pav2000/ControlHeatPump2.0/Doc/OmronMX2.pdf

Пример настройки на компрессор с постоянными магнитами для Omron MX2

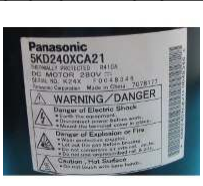
[picture p15: figure]
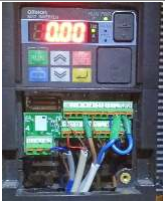
[picture p16: figure]

Необходимо переключится на PM мотор (b171=03) обнулить и сделать автонастройку
После выбора режима управления PM-двигателем (b171=03) и после выполнения инициализации (b180=01) большинство параметров группы «H», ориентированных на стандартный асинхронный двигатель, заменяется новыми параметрами. Эти новые параметры, используемые для регулировки характеристик двигателя,
Буква | Номер | Значение | Примечание
Н | 001 | 1
| 102 01
| 103 2.2
| 104 4
| 105 11
| 106 | 0.55 | Сопротивление одной обмотки
| 107 2.31
| 108 2.7
| 109 | 810 | надо подбирать влияет на потребление и шум
| 110 0.01
| 111 0.55
| 112 1.97
| 113 4.94
| 116 100
| 117 70
| 118 1
| 119 | 100 | надо подбирать наверное ?
| 121 0
| 122 50
| 123 0
| 131 10
| 132 10
| 133 30

| 134 100
c | 001 | 0 | Команда ход, настройка по умолчанию
c | 004 | 18 | Сброс ПЧ, настройка по умолчанию
c | 005 | 19 | (не настройка по умолчанию, надо менять) Подключение термореле к 5 входу (НЗ) цепляем на 5 и L
с | 026 | 05 | Сигнал ошибки от ПЧ (стандартная настройка) это выход ПЧ
b | 091 | 01 | Останов с выбегом
| 021 | 01 | Режим работы при перегрузке: включено во время разгона и вращения с постоянной скоростью
| 022 Задает уровень ограничения перегрузки в диапазоне от 20% | | до 200% от номинального тока ПЧ
| 023 | 1.0 | Задает время торможения при ограничении перегрузки обнаружении преобразователем перегрузки
| 171 | 03 | тип двигателя PM (постоянные магниты) Это первая настройка!!!
F | 002 | 20
| 003 20
A | 001 | 03 | Modbus источник управления
| 002 | 01 | Команда ход - Клеммы управления
| 003 120
| 004 120

Настройка плавного разгона-торможения
1. Определение максимальных частот.
Идем в даташит на компрессор и смотрим максимальные обороты. Дальше по формуле определяем максимальную частоту
Мах частота = (мах. обороты компрессора*число пар полюсов компрессора)/120
Для примера моего компрессора: максимальные обороты у меня 4800
Максимальная частота = 4800*4/120=160 гц - это тот максимум который можно подавать Важно понимать что существует определенная путаница в терминах в документации число пар полюсов и число полюсов. Обычно в независимости от того что написано имеется ввиду число пар полюсов.

### 2. Программирование верхних ограничений частот омрона

регистр A004 Максимальная частота (для моего компрессора я поставил 120, мне больше не надо, можно было поставить 160)
регистр A003 Основная частота должна быть меньше либо равна А004 (для себя установил 110). Это частота до которой с ростом частоты растет напряжение (дальше до максимальной частоты напряжение не растет).

### 3. Программирование времен разгона и торможения

регистр F002 Время разгона (у меня 30 сек)
регистр F003 Время торможения (у меня 30 сек)
В итоге получаем (при моих установках) при команде ход у установке целевой частоты 55 гц время разгона будет около 15 сек, т. е время разгона пропорционально изменению частоты.

При изменении частоты с 40 до 95 герц также будет разгон 15 секунд. Тоже с торможением.

Важные замечания:

### 1. Если разгон и торможение происходит плавно, то все ок и больше ничего не трогаем. При

рывках, вибрации, шуме (именно при разгоне), срабатывании защит, начинаем использовать встроенные средства омрона для борьбы ними (вырез частот, паузы при разгоне, настройка срабатывания защит, и т. д.). Можно сделать нелинейную характеристику разгона. Пока я не настроил нормально PM мотор у меня были проблемы на частоте 18-19 гц (резко росла нагрузка на этой частоте, может в компрессоре что открывалось).

### 2. Можно переключиться в режим торможение с выбегом, это значит просто снятие

напряжений с компрессора, он тормозится сам (т.е почти мгновенно, главное что бы удара не было в момент останова). У меня сейчас стоит останов с выбегом.

### 3. По настройке PM мотора омрон (большой документ, не выложить здесь)

скачиваем (https:/industrial.omron.us/en/media/MX2-V1_Inverter_Users_Manual_EN_201305_I585-E1-01_tcm849-112647.pd_f) и читаем раздел 6.8 -это наиболее полная инструкция по настройке и описанию параметров PM мотора Подчеркивание (1 шт из расширения файла) из ссылки убираем

### 4. Необходимо помнить что НК (страница конфигурация Тн - инвертор - доп. настройки) есть

также настройки максимальных и минимальных частот (это просто ограничения для изменения). Они должны соответствовать настройкам омрона.

Программирование входов/выходов

### 1. ВХОД5 Использование термозащиты компрессора (термореле), используется не стандартная

настройка С005=19 (термозащита), надо изменить регистр С005.

### 2. ВХОД1 Использование входа «Ход» используется настройка по умолчанию С001=00 3. ВХОД4 Использование сброса ПЧ — используется штатная настройка С004=18 4. ВЫХОД1 Сигнал ошибки используется штатная настройка С026=05

Начиная с прошивки 1.030 в НК есть возможность установить требуемые настройки ПЧ через НК (кнопка программирование в доп настройках инвертора). Но надо понимать, что это настройки для однофазного инвертора 2.2 кВт с указанным выше компрессором.

HITACHI | OMRON

## Элементы пульта оператора

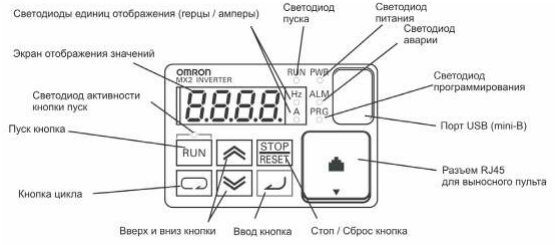
[picture p17: figure]

### - Светодиод пуска – загорается при подаче команды на запуск двигателя во

время начала вращения и отключается при остановке мотора.

### - Светодиод программирования – загорается при готовности к изменению

значений параметров и отключается в режиме контроля текущих параметров.

### - Светодиод активности кнопки пуск – загорается при активированной кнопке

и возможности с нее подать команду на запуск мотора.

### - Кнопка пуска Run – при нажатии производится запуск двигателя (сначала должен светиться светодиод над кнопкой). Направление вращения двигателя

можно задавать через функцию F004.

### - Кнопка Stop/Reset – при нажатии производится остановка двигателя (при этом используется значение времени замедления), а также, происходит сброс

возникающих ошибок.

### - Экран отображения значений – 4-х разрядный, 7-ми сегментный индикатор

для программирования и отображения параметров и текущих значений.

### - Светодиоды: Hz, A – загораются при отображении на экране частоты или

тока, соответственно.
- Светодиод Power – загорается при подаче питания на инвертор.
- Светодиод Alarm – загорается, когда инвертор в состоянии “Сбой”.
- Кнопка цикла – используется для входа в режим программирования, перемещения по группам параметров и функций.

### - Кнопки вверх и вниз – используются для перемещения вверх/вниз по списку внутри 1 группы параметров и функций отображаемых на индикаторе и для

изменения их значений.

### - Кнопка ввода – используется для входа в отображаемый параметр или функцию, для выхода из нее с сохранением установленного значения в

памяти EEPROM.

________________________________________________________________________ 10

## Испытание инвертора

### Процедура испытания требует минимум установочных параметров для запуска двигателя. Управление инвертором может осуществляться двумя

способами: посредством пульта оператора и через логические клеммы.

### Внимание! - Проверьте правильность подключения питающей сети и двигателя к

инвертору (см. схему).

### - Если для испытания используются логические клеммы, убедитесь, что

подключения клемм инвертора [P24], [1], [2], [H], [O] и [L] совпадают со схемой.
операций Шаги | Описание | Управление с пульта оператора | Управление через логические клеммы
1 | Установка источника задания частоты. * - заводская настройка | А001 = 02 (ввод значения выходной частоты в параметре F001) | А001 = 01*, (регулировка через аналоговые входы [H-O-L])
2 | Установка источника управляющих команд Пуск, в прямом направлении. * - заводская настройка | А002 = 02 (запуск мотора кнопкой RUN на пульте оператора) | А002 = 01*, (запуск мотора дискретным входом [1])
3 | Изменение направления вращения. | F004 = с 00* на 01 (запуск мотора кнопкой RUN на пульте оператора) | А002 = 01*, (запуск мотора дискретным входом [2])
4 | Установка номинальной частоты двигателя | А003 = 50*, (50 Гц)
5 | Установка числа полюсов двигателя (2 / 4 / 6 / 8) | Н004 = 4*, изменяйте только в том случае, если двигатель имеет другое число полюсов
6 | Вывод отображения текущей выходной частоты на индикаторе панели оператора | Выберите из группы параметров d параметр d001, нажмите кнопку Ввод., на индикаторе появится 0.0 – значение текущей частоты
7 | Установите среднее значение задания частоты | В параметре F001 установите 25Гц | Подайте около 5В на клеммы [О]-[L]
8 | Дайте команду Пуск мотора | Нажмите кнопку RUN. Мотор должен начать разгон. | Замкните клемму [Р24] и [1]. Мотор должен начать разгон.
9 | Изменение скорости мотора | В F001 измените значение частоты. Мотор изменит скорость. | Измените напряжение на [О]-[L]. Мотор изменит скорость.
10 | Контроль потребляемого тока | Отображение потребляемого мотором тока в d002. Потребляемый ток должен быть меньше или равен номинальному току преобразователя частоты.
11 | Остановка мотора | Нажмите кнопку STOP/RESET. Мотор должен начать остановку. | Разомкните клеммы [Р24] и [1]. Мотор должен начать остановку.

12

## Коды ошибок

Преобразователи частоты серии МХ2 имеют защиту от перегрузки по току,

### от повышенного/ пониженного напряжения и много других. При срабатывании защиты отключается выход инвертора и остановка двигателя происходит в режиме свободного выбега. Перезагрузка частотного преобразователя и сброс ошибки

производится нажатием кнопки STOP/RESET.
Код ошибки | Наименование | Возможные причины сбоя
E01 | Защита от перегрузки по току при постоянной скорости | - Замыкание на выходе инвертора - Блокировка вала двигателя - Слишком большая нагрузка - Неправильно совершено подключение мотора Замечание: для серии SJ200 защита от перегрузки по току будет срабатывать при перегрузке 200% от номинального тока
E02 | Защита от перегрузки по току при замедлении
E03 | Защита от перегрузки по току при разгоне
E04 | Защита от перегрузки по току при других условиях | - Установлен слишком большой тормозной момент (А054) - Влияние электромагнитных помех на трансформатор тока
E05 | Защита от перегрузки | Электронное тепловое реле определило перегрев мотора
E06 | Защита от перегрузки тормозного резистора | Превышается время или коэффициент использования регенеративного торможения, слишком большой ток торожения
E07 | Защита от повышенного напряжения | Энергия, отдаваемая двигателем при торможении, вызывает увеличение напряжения в контуре постоянного тока выше порогового значения
E08 | Ошибка EEPROM | Влияние электромагнитных помех или высокой температуры на встроенную память EEPROM
E09 | Защита от пониженного напряжения | Пониженное напряжение в контуре постоянного тока может вызвать неправильное функционирование инвертора
E10 | Ошибка измерения тока | Выход из строя цепей измерения потребляемого мотором тока
E11 | Ошибка CPU | Сбои в работе микропроцессорного модуля CPU
E12 | Сбой во внешней цепи | Подан сигнал на дискретный вход с функцией [EXT] (сбой в работе внешнего устройства)
E13 | USP – предотвращение перезапуска при восстановлении питания | Когда на инвертор подаётся питание при наличии команды Пуск мотора происходит сбой с блокировкой возможность запуска пока не сброшен сбой, если активна функция USP

13

Код ошибки | Наименование | Возможные причины сбоя
E14 | Защита от замыкания на землю | Замыкание на землю между выходом инвертора и корпусом мотора (заземлением) в момент теста питания (между подачей питания на ПЧ и пуском мотора). Данная функция обеспечивает защиту инвертора, но не людей.
E15 | Защита от повышенного напряжения на входе | Сетевое напряжение превышало допустимое значение в течение 100сек режима Стоп.
E21 | Тепловая защита | Внутренняя температура инвертора (силового модуля) превышает пороговое значение.
E22 | Ошибка связи с CPU | Ошибка связи между двумя процессорами
E25 | Авария основных цепей | Влияние помех или повреждение цепей основных элементов.
E30 | Ошибка драйвера | Внутренняя ошибка в цепях защиты между CPU и драйвером из-за влияния помех или повреждения.
E35 | Термисторная защита | Происходит если термистор, подключенный к клеммам 5 (с функцией ТНМ) и L слишком сильно нагрелся
E36 | Ошибка тормоза | Происходит если в b120 установлен 01 и не получен сигнал подтверждения от тормоза после истечения времени b124. Или когда выходной ток не достигает значения b126 в течение времени b121.
E37 | Безопасный стоп | Подан сигнал безопасного стопа
E38 | Защита от перегрузки на маленькой скорости | Перегрузка во время работы мотора на очень маленькой скорости
E40 | Ошибка пульта оператора | Проблема связи между инвертором и клавиатурой пульта оператора
E41 | Ошибка связи сети ModBus | Если С076=00 и произошла проблема связи в сети ModBus
E43 | Некорректная инструкция в программе EzSQ | Программа сохраненная в памяти инвертора уничтожена, или терминал PRG был включен без программы загруженной в инвертор.
E44 | Ошибка счета в программе EzSQ | Подпрограммы, if-условия, или for-циклы вложены в более чем в восемь уровней
E45 | Ошибка инструкции в программе EzSQ | Инвертор обнаруживал команду, которая не может быть выполнена (взаимопротиворечие).
E50 – E59 | Пользовательские ошибки (0 – 9) в программе EzSQ | Ошибка пользователя, заложенная в программе EzSQ
E60 – E69 | Ошибки в подключенных опциональных платах | Детальные пояснения каждой из ошибок в инструкции к опциональной плате

14

Код ошибки | Наименование | Возможные причины сбоя
E80 | Отключение энкодера | Если провода энкодера разъединены, обнаружена ошибка подключения, повреждение энкодера или выходной сигнал энкодера не поддерживается преобразователем
E81 | Превышение скорости | Скорость мотора выше значения А004хР026
E83 | Ошибка диапазона позиционирования | Если текущая позиция превышает диапазон позиционирования P072-P073
| Сброс. (вращение сегментов на дисплее) | На дискретный вход с функцией RS подается управляющее напряжение или нажата кнопка Stop/Reset
| Пониженное напряжение | Входное напряжение питания ниже порогового значения
| Ожидание перезапуска | Отображается после аварии перед рестартом
| Команда ограничения работы | Ограничение направления с командой RUN в параметре b035
| Сброс истории ошибок | Отображается во время сброса истории ошибок
| Нет данных, отсутствие ошибок в архиве | В архиве отсутствует авария / предупреждение
| Ошибка связи (мигает) | Проблема связи между инвертором и вспомогательным выносным пультом
| Автонастройка завершена успешно | Автонастройка завершена успешно
| Автонастройка не удалась | Автонастройка не удалась

15

## Ошибки программирования

### Преобразователи частоты имеют специальные коды - коды ошибок программирования (они начинаются символом ).Коды ошибок программирования означают, что при программировании была допущена ошибка и установленные

значения параметров противоречат одно другому. После обнаружения конфликта,

### на экране высвечивается определенный код, также происходит мигание светодиода PRG до тех пор, пока в соответствующем параметре не будет установлено значение из требуемого диапазона. Последний из кодов ошибок программирования

фиксируется в параметре D090.

Код предупреждения | Условия
001 | А061 | > | А004
002 | А062 | > | А004
005 | F001 или A020 | > | A004
015 | F001 или A020 | > | A061
025 | A062 | > | F001 или A020
031 | A082 | > | A061
032 | A082 | > | A062
035 | A082 | > | F001 или A020
036 | A082 | > | A021 – A035
037 | A082 | > | A038
085 | F001 или A020 | = | A063/A063/A063 ± A064/A066/A068
086 | A021 – A035 | = | A063/A063/A063 ± A064/A066/A068
091 | B112 | > | A061
092 | B112 | > | A062
095 | B112 | > | F001 или A020
201 | А261 | > | А204
202 | А262 | > | А204
205 | F001 или A220 | > | A204
215 | F001 или A220 | > | A261
225 | A262 | > | F001 или A220
231 | A082 | > | A261
232 | A082 | > | A262
235 | A082 | > | F001 или A220
285 | F001 или A220 | = | A063/A063/A063 ± A064/A066/A068
291 | B112 | > | A261
292 | B112 | > | A262
295 | B112 | > | F001 или A220

17

## Восстановление заводских стандартных настроек

Функцио-нальный код | Наименование/Описание
b084 | Режим инициализации (параметров или истории ошибок): • 00: инициализация не происходит, • 01: очистка истории сбоев, • 02: установка заводских параметров, • 03: очистка истории сбоев и установка заводских параметров, • 04: очистка истории сбоев и установка заводских параметров и сброс программы
b094 | Инициализация параметров: • 00: все параметры, • 01: все параметры, кроме функций входов, выходов и коммуникационных, • 02: только параметры из Uxxx, • 03: все параметры, кроме Uxxx и b037
b085 | Код страны для инициализации: • 00: Япония / США, • 01: Европа
b180 | Триггер, выпоняющий инициализацию с учетом b084, b085, b094: • 00: инициализация невозможна, • 01: инициализация выполниется

18

## Внимание, это важно!!!

## Подробное описание всех указанных, а также специальных параметров и функций представлено в полной версии инструкции по

эксплуатации данного оборудования.

## (смотрите на CD в комплекте поставки или спрашивайте у поставщика)

## Таблицы параметров

## Группа параметров «D»: функции отображения информации

Функцио-нальный код | Наименование/Описание | Единицы измерения
d001 | Отображение текущей выходной частоты 0.00 – 400.0Гц Если в b163 установлено 01, то задание частоты возможно в параметре d001 кнопками вверх/вниз (как в F001) | Гц
d002 | Отображение выходного тока, потребляемого мотором | А
d003 | Отображение режимов вращения вала двигателя Прямое Стоп | | | -
d004 | Действительное значение сигнала обратной связи при ПИД-регулировании (PV). Его масштабирование/ привязка к физической величине производится в А075 | | | %
d005 | Состояние программируемых входных логических клемм | | 67 | | 12345 | -
d006 | Состояние программируемых выходных логических клемм | -
d007 | Отображение преобразованного значения выходной частоты (произведение выходной частоты на поправочный коэффициент, устанавливаемый в b086). | Определяется пользователем
d008 | Отображение текущей частоты, от -400 до 400 | Гц
d009 | Отображение задания крутящего момента, от -200 до +200 | %
d010 | Отображение ограничения крутящего момента, от -200 до +200 | %
d012 | Отображение текущего крутящего момента, от -200 до +200 | %
d013 | Отображение выходного напряжения, от 0.0 до 600.0 | В
d014 | Отображение потребляемой мотором мощности, от 0.0 до 999.9 | кВт
d015 | Счетчик потребленной электроэнергии из сети, от 0 до 9999000 | кВт/ч
d016 | Общее время работы преобразователя частоты с двигателем. Диапазон: 0…9999 / 1000…9999 / Г100…Г999 (10000…99900) | час
d017 | Общее время подключения преобразователя частоты к сети. Диапазон: 0…9999 / 1000…9999 / Г100…Г999 (10000…99900) | час
d018 | Отображение температуры радиатора, от -020. до 150.0 | °С

19

Вкл
Выкл

Номера входов

Вкл
Выкл

1112
Номера выходов

AL

Обратное
вращение

вращение

## Группа параметров «F»

Функциональный код | Наименование/ Описание | Значение по умолчанию | Установленное значение
F001 | Установка выходной частоты | 0.0Гц
F002 | Установка времени разгона (1-я ступень) | 10.0с
F202 | Установка времени разгона для 2-го двигателя (1-я ступень) | 10.0с
F003 | Установка времени торможения (1я ступень) | 10.0с
F203 | Установка времени торможения для 2-го двигателя (1-я ступень) | 10.0с
F004 | Установка направления вращения двигателя при его запуске кнопкой RUN с пульта оператора: - 00: прямое вращение - 01: обратное вращение | 00

20

Функцио-нальный код | Наименование/Описание | Единицы измерения
d022 | Контроль работоспособности
d023 | Отображение счетчика программы, 0 до 1024, функция контроллера
d024 | Отображение номера программы, функция контроллера
d025 | Монитор 0 пользователя, функция контроллера, -2147483647 до 2147483647
d026 | Монитор 1 пользователя, -2147483647 до 2147483647
d027 | Монитор 2 пользователя, -2147483647 до 2147483647
d028 | Счетчик импульсов, 0 до 2147483647 | | имп
d029 | Отображение задания позиционирования, -268435455 до 268435455 | | имп
d030 | Отображение текущей позиции, -268435455 до 268435455 | | имп.
d050 | Отображение 2 различных параметров выбранных в b160и b161
d060 | Текущее состояние инвертера: I-C: , I-v: , P:
d080 | Счетчик сбоев преобразователя, от 0 до 65530 | | шт.
d081 | Отображение сбоя 1, причина, частота, ток, напряжение, время работы, время включения
d082 | Отображение сбоя 2, причина, частота, ток, напряжение, время работы, время включения
d083 | Отображение сбоя 3, причина, частота, ток, напряжение, время работы, время включения
d084 | Отображение сбоя 4, причина, частота, ток, напряжение, время работы, время включения
d085 | Отображение сбоя 5, причина, частота, ток, напряжение, время работы, время включения
d086 | Отображение сбоя 6, причина, частота, ток, напряжение, время работы, время включения
d090 | Отображение ошибки программирования (код предупреджения)
d102 | Напряжение в цепи постоянного тока, от 0.0 до 999.9 | | В
d103 | Степень нагрузки на встроенное тормозное устройство, 0.0 до 100.0 | | %
d104 | Отображение расчетной тепловой нагрузки мотора, электронное тепловое реле, 0.0 до 100.0 | | %

Проблема
Нормально

12
1 - конденсаторы на основной плате, 2 - охлаждающие вентиляторы

## Группа параметров «А»

Функциональный код | Наименование / Описание | Значение по умолчанию | Установленное значение
А001 / А201 | Установка источника задания частоты: - 00: потенциометром на пульте оператора, - 01: внешними аналоговыми сигналами через клеммы, - 02: с помощью функции F001, - 03: через сеть ModBus, - 04: опция, - 06: последовательностью импульсов, - 07: программой контроллера, - 10: через функцию вычисления, | 01
А002 / А202 | Установка источника команды на запуск двигателя: - 01: с помощью дискретных входов, - 02: кнопкой RUN на пульте оператора или цифровым оператором, - 03: через сеть ModBus, - 04: опция, | 01
А003 / А203 | Установка номинальной частоты мотора | 60.0Гц
А004 / А204 | Установка максимальной частоты, от номинальной до 400 | 60.0Гц
А005 | [АТ]: выбор входа задания частоты - 00: производится выбор между входами [O] и [OI] ([АТ]: ВКЛ= OI, ВЫКЛ=О), - 02: выбор между входом [O] и потенциометром на пульте оператора ([АТ]: ВКЛ= пот., ВЫКЛ=О), - 03: выбор между входом [OI] и потенциометром на пульте оператора ([АТ]: ВКЛ= пот., ВЫКЛ= OI), | 00
А011 | Частота соответствующая начальной точке аналогового входа [O]. | 0.0Гц
А012 | Частота соответствующая конечной точке аналогового входа [O]. | 0.0Гц
А013 | Напряжение, соответствующее рабочего диапазона аналогового входа [O] относительно 10В | 0%
А014 | Напряжение, соответствующее концу рабочего диапазона аналогового входа [O] относительно 10В | 100%
А015 | Стартовая частота при задании со входа [O] - 00: значение в А011 - 01: 0Гц | 01
А016 | Постоянная времени фильтра аналогового входа, от 1 до 30 х2мс, 31=500мс | 8.
А017 | Выбор функционирования встроенного программируемого контроллера: - 00: не работает, - 01: работает, | 00
А019 | Выбор функционирования многоскоростного режима: - 00: двоичным кодом 16 скоростей используя 4 дискретных входа, - 01: битовым выбором 8 скоростей используя 7 дискретных входов, | 00

21

Функциональный код | Наименование / Описание | Значение по умолчанию | Установленное значение
А020 / А220 | Нулевая скорость первого /второго мотора при многоскоростном режиме | 0.00Гц
А021 А022 А023 | А035 | Установка частоты для каждой отдельной ступени скорости (от 1 до 15) при режиме ступенчатого задания скорости | 0.00Гц
А038 | Установка частоты для режима «Jog» | 6.00Гц
А039 | Установка метода остановки мотора после режима «Jog»: - 00: свободный выбег, режим «Jog» невозможен во время вращения двигателя, - 01: торможение по заданному времени замедления, режим «Jog» невозможен во время вращения двигателя, - 02: торможение постоянным током, режим «Jog» невозможен во время вращения двигателя, - 03: свободный выбег, режим «Jog» возможен во время вращения двигателя, - 04: замедление и стоп, режим «Jog» возможен во время вращения двигателя, - 05: торможение постоянным током, режим «Jog» возможен во время вращения двигателя, | 04
А041 / А241 | Установка способа повышения крутящего момента - 00: вручную - 01: автоматически | 00
А042 / А242 | Установка значения повышения момента для ручного режима, от 0 до 20% относительно линейной V/f-хар. | 1.0%
А043 / А243 | Частота, соответствующая точке повышения момента на V/f-хар. для ручного режима, от 0 до 50% (100%=А004) | 5.0%
А044 / А244 | Выбор вида кривой V/f – характеристики - 00: V/f – линейная (постоянный момент), - 01: V/f – квадратичная (пониженный момент 1.7), - 02: создаваемая V/f, - 03: безсенсорный векторный режим, | 00
А045 / А245 | Величина выходного напряжения | 100%
А046 / А246 | Значение компенсации напряжения при автоматическом повышении момента | 100.
А047 / А247 | Значение компенсации скольжения при автоматическом повышении момента | 100.
А051 | Активация торможения постоянным током: - 00: не действует, - 01: действует в режиме стоп, - 02: действует со значения частоты, | 00
А052 | Установка частоты активации торможения постоянным током, от b082 до 60Гц | 0.5Гц
А053 | Установка времени ожидания перед активацией торможения постоянным током, от 0 до 5с | 0.0с

22

23

Функциональный код | Наименование / Описание | Значение по умолчанию | Установленное значение
А054 | Установка момента торможения постоянным током при замедлении, от 0 до 100% | 50%
А055 | Установка времени торможения постоянным током при замедлении, от 0 до 60с | 0.5с
А056 | Торможения постоянным током: - 00: включается появлением [DB] и действует время А055, - 01: включается и действует в течении наличия сигнала [DB], | 01
А057 | Установка момента торможения постоянным током при разгоне, от 0 до 100% | 0%
А058 | Установка времени торможения постоянным током при разгоне, от 0 до 60с | 0.0с
А059 | Установка несущей частоты при торможении постоянным током, от 2 до 15кГц | 5.0кГц
А061/А261 | Установка верхней границы частоты, от А062 до А004, значение 0 отключает ограничение. | 0.0Гц
А062/А262 | Установка нижней границы частоты, b082 до А061, значение 0 отключает ограничение. | 0.0Гц
А063 А065 А067 | Установка резонансной частоты | 0.0Гц
А064 А066 А068 | Установка ширины скачка (гистерезиса) | 0.5Гц
А069 | Частота начала задержки разгона | 0.00Гц
А070 | Время задержки разгона | 0.0с
А071 | Активация ПИД-регулятора - 00: не действует, - 01: действует, - 02: действует с инвертированием, | 00
А072 | Пропорциональная составляющая | 1.0
А073 | Интегральная составляющая | 1.0с
А074 | Дифференциальная составляющая | 0.0с
А075 | Коэффициент масштабирования сигнала обратной связи для ПИД-регулятора (PV) | 1.00
А076 | Установка входа для сигнала обратной связи (PV): - 00: аналоговый вход [OI], - 01: аналоговый вход [O], - 02: сеть ModBus, - 03: импульсный вход, - 10: через функцию вычисления, | 00
А077 | Реверсирование ПИД-регулятора: - 00: выключено, - 01: включено, | 00
А078 | Ограничение выхода ПИД-регулятора | 0.0%
А079 | Выбор прямого значения ПИД-регулятора: - 00: не активен, - 01: аналоговый вход [O], - 02: аналоговый вход [OI], | 00

24

код | | умолчанию | значение
А081 / A281 | Режимы работы функции АРН (автоматическое регулирование напряжения): - 00: действует всегда, - 01: не действует, - 02: не действует при торможении | 00
А082 / A282 | Установка напряжения для режима АРН | 400
А083 | Постоянная времени фильтра АРН | 0.3с
А084 | Коэффициент замедления для АРН | 100%
А085 | Режим функционирования: - 00: нормальное функционирование, - 01: энергосберегающий режим, | 00
А086 | Настройка энергосберегающего режима | 50.0%
А092 / А292 | Время разгона по второй ступени | 10.0с
А093 / А293 | Время торможения по второй ступени | 10.0с
А094/А294 | Выбор способа перехода на Ускорение2 / Торможение2: - 00: подачей сигнала на вход 2СН, - 01: достижением частот А095 и А096, - 02: сменой направления вращения, | 00
А095/А295 | Установка частоты перехода с первой ступени ускорения на вторую | 0.0Гц
А096/А296 | Установка частоты перехода с первой ступени торможения на вторую | 0.0Гц
А097 | Выбор кривой разгона: - 00: линейная, - 01: S-образная, - 02: U-образная, - 03: ∩-образная, - 04: EL-S-образная, | 00
А098 | Выбор кривой торможения: - 00: линейная, - 01: S-образная, - 02: U-образная, - 03: ∩-образная, - 04: EL-S-образная, | 00
А101 | Частота соответствующая начальной точке аналогового входа [OI]. | 0.0Гц
А102 | Частота соответствующая конечной точке аналогового входа [OI]. | 0.0Гц
А103 | Ток, соответствующий началу рабочего диапазона аналогового входа [OI] относительно 20мА | 20.0%
А104 | Ток, соответствующий концу рабочего диапазона аналогового входа [OI] относительно 20мА | 100%
А105 | Стартовая частота при задании со входа [OI] - 00: значение в А101 - 01: 0Гц | 00
А131 | Постоянная кривой разгона: - 00: наименьшая выпуклость, … - 10: наибольшая выпуклость | 02
А132 | Постоянная кривой замедления: - 00: наименьшая выпуклость, … - 10: наибольшая выпуклость | 02

код | | умолчанию | значение
А141 | Выбор ввода 1 для функции вычисления - 00: пульт оператора -F001, - 01: пульт оператора -потенциометр, - 02: вход [О], - 03: вход [OI], - 04: сетевой порт, - 05: опция, - 07: импульсный вход, | 02
А142 | Выбор ввода 2 для функции вычисления - 00: пульт оператора -F001, - 01: пульт оператора -потенциометр, - 02: вход [О], - 03: вход [OI], - 04: сетевой порт, - 05: опция, - 07: импульсный вход, | 03
А143 | Вычислительные действия: - 00: сумма А141+А142, - 01: вычитание А141-А142, - 02: умножение А141*А142, | 00
А145 | Прибавляемое значение частоты, ADD | 0.00Гц
А146 | Выбор действия для добавления частоты: - 00: выходная частота + А145, - 01: выходная частота - А145, | 00
А150 | EL-S-образная кривая разгона участка 1 | 10%
А151 | EL-S-образная кривая разгона участка 2 | 10%
А152 | EL-S-образная кривая остановки участка 1: от 0 до 50 | 10%
А153 | EL-S-образная кривая остановки участка 1: от 0 до 50 | 10%
А154 | Частота задержки замедления | 0Гц
А155 | Время задержки замедления | 0с
А156 | Нижний порог функционирования ПИД, ниже этого значения ПИД отключается | 0Гц
А157 | Время ожидания перед отключением/ включением ПИД при пересечении А156 | 0с
А161 | Частота соответствующая начальной точке встроенного потенциометра. | 0Гц
А162 | Частота соответствующая конечной точке встроенного потенциометра | 0Гц
А163 | Положение (уровень) начала встроенного потенциометра | 0%
А164 | Положение (уровень) конца встроенного потенциометра | 100%
А165 | Стартовая частота при задании встроенного потенциометра - 00: значение в А161 - 01: 0Гц | 01

25

## Группа параметров «В»:

Функциональный код | Наименование / Описание | Значение по умолчанию | Установленное значение
b001 | Выбор режима перезапуска после провала напряжения питания: - 00: выдача сообщения об ошибке, - 01: старт с частоты 0Гц, - 02: старт с подхватом текущей частоты, - 03: старт с подхватом текущей частоты и остановка с выдачей сообщения об ошибке, - 04: ?, | 00
b002 | Допустимое время провала напряжения питания от 0.3 до 25.0 с | 1.0с
b003 | Время ожидания перед перезапуском мотора от 0.3 до 100 с | 1.0с
b004 | Выдача сообщения о провале питания или о пониженном напряжении: - 00: не активирована, - 01: активирована, - 02: не активна при замедлении и стопе, | 00
b005 | Количество перезапусков при провале напряжения питания до появления сбоя: - 00: перезапуск производится 16 раз, - 01: перезапуск производится всегда, | 00
b007 | Порог частоты подхвата. Перезапуск произведется с 0Гц если скорость мотора соответствует частоте ниже этой | 0.00Гц
b008 | Выбор повторной попытки после сбоя по перенапряжению или перегрузки по току: - 00: сообщение об ошибке без перезапуска, - 01: старт с частоты 0Гц, - 02: старт с подхватом текущей частоты, - 03: старт с подхватом текущей частоты и остановка с выдачей сообщения об ошибке, 04: ?, | 00
b010 | Выбор повторной попытки после сбоя по перенапряжению или перегрузки по току:: от 1 до 3 раз | 3
b011 | Время ожидания после сбоя по перенапряжению или перегрузки по току: от 0.3 до 100 с | 1.0с
b012 / b212 | Уровень установки электронного теплового реле | Ном. ток инвертора
b013 / b213 | Характеристика электронного теплового реле: - 00: пониженный момент, - 01: постоянный момент - 02: настраиваемая характеристика, | 01
b015 | Настраиваемая тепловая характеристика, частота 1 | 0Гц
b016 | Настраиваемая тепловая характеристика, ток 1 | 0.0А
b017 | Настраиваемая тепловая характеристика, частота 2 | 0Гц
b018 | Настраиваемая тепловая характеристика, ток 2 | 0.0А

26

код | | умолчанию | значение
b019 | Настраиваемая тепловая характеристика, частота 3 | 0Гц
b020 | Настраиваемая тепловая характеристика, ток 3 | 0.0А
b021 / b221 | Режим ограничения тока: - 00: не действует, - 01: действует при разгоне и постоянной скорости, - 02: действует при постоянной скорости, - 03: действует при разгоне и постоянной скорости, включая скорости с генераторным режимом, | 01
b022 / b222 | Установка уровня ограничения тока, А | Ном. ток × 1.5А
b023 / b223 | Время замедления для режима ограничения тока | 1.0с
b024 | Режим 2 ограничения тока: - 00: не действует, - 01: действует при разгоне и постоянной скорости, - 02: действует при постоянной скорости, - 03: действует при разгоне и постоянной скорости, включая скорости с генераторным режимом, | 01
b025 | Установка 2 уровня ограничения тока, А | Ном. ток × 1.5А
b026 | Время 2 замедления для режима ограничения тока | 1.0с
b027 | Сдерживание перегрузки по току: - 00: не возможно, - 01: возможно, | 01
b028 | Значение тока для функции активного подхвата частоты, А | Ном. ток инвертора
b029 | Диапазон замедления для функции активного подхвата частоты | 0.5с
b030 | Стартовая частота для функции активного подхвата частоты: - 00: частота предыдущего отключения, - 01: максимальная частота, - 02: установленная частота, | 00
b031 | Выбор способа блокировки параметров - 00: редактирование параметров кроме В031 блокируется подачей сигнала [SFT], - 01: редактирование параметров кроме В031 и F001 блокируется подачей сигнала [SFТ], - 02: все кроме В031 блокируется, - 03: все кроме В031 и F001 блокируется, - 10: не блокируется изменение данных, | 01
b033 | Длинна кабеля к мотору | 10м
b034 | Установка счетчика времени работы/включения для выходного сигнала | 0час
b035 | Ограничение направления вращения: - 00: возможно вперед и назад, - 01: возможно только вперед, - 02: возможно только назад, | 00

27

код | | умолчанию | значение
b036 | Выбор возможности запуска при пониженном напряжении питания: - 0: отключено, -1: примерно 6мс, … - 255: примерно 1.5с, | 2
b037 | Ограничения отображаемых данных на дисплее: - 00: все данные отображаются, - 01: отображаются специальные функции, - 02: отображаются параметры пользователя (U), - 03: отображаются данные сравнения, - 04: основной дисплей, - 05: только функции группы d | 04
b038 | Выбор параметра для начального экрана: 001… 030 = d001 … d030, 201 = F001, 202 = ? | 001
b039 | Автоматическая регистрации параметров пользователя: - 00: не активна, - 01: активна, | 00
b040 | Выбор ограничения момента: - 00: поквадрантное ограничение, - 01: переключение с клемм управления, - 02: аналоговым входом О, | 00
b041 | Ограничение 1, движение вперед в 4 квадрантном режиме, от 0 до 200 % | 200%
b042 | Ограничение 2, движение назад с регенерацией в 4 квадрантном режиме, от 0 до 200 % | 200%
b043 | Ограничение 3, движение назад в 4 квадрантном режиме, от 0 до 200 % | 200%
b044 | Ограничение4, движение вперед с регенерацией в 4 квадрантном режиме, от 0 до 200 % | 200%
b045 | Ограничение момента, режим LADSTOP: - 00: не активна, - 01: активна, | 00
b046 | Защита от вращения назад: - 00: не активна, - 01: активна, | 01
b049 | Установка двойного значения: - 00: СТ-режим, - 01: VT-режим | 00
b050 | Управляемая остановка и стоп при пропадании напряжения питания (режим беспрерывной работы): - 00: авария, - 01: беспрерывное замедление и стоп, - 02: замедление с контролем DC напряжения, - 03: замедление с контролем DC напряжения, затем перезапуск | 00
b051 | Уровень переключения DC напряжения при пропадании питания: от 0 до 1000 В | 440В
b052 | Порог перенапряжения при пропадании питания: от 0 до 1000 В | 720В

28

код | | умолчанию | значение
b053 | Время замедления при пропадании питания: от 0.01 до 3600 с | 1с
b054 | Начальное понижение выходной частоты при пропадании питания: от 0.00 до 10.00 Гц | 0.00Гц
b060 | Максимальное значение окна компаратора О, от (b061 + гистерезис b062х2) до 100% | 100%
b061 | Минимальное значение окна компаратора О, от 0 до (b060 - гистерезис b062х2) | 0%
b062 | Ширина гистерезиса окна компаратора О, от 0 до (b060 - b061)/2 | 0%
b063 | Максимальное значение окна компаратора ОI, от (b064 + гистерезис b065х2) до 100% | 100%
b064 | Минимальное значение окна компаратора ОI, от 0 до (b063 - гистерезис b065х2) | 0%
b065 | Ширина гистерезиса окна компаратора ОI, от 0 до (b063 - b064)/2 | 0%
b070 | Рабочий уровень отключения О, от 0 до 100% или “no”-игнорирование | no
b071 | Рабочий уровень отключения ОI, от 0 до 100% или “no”-игнорирование | no
b075 | Температура окружающего воздуха: -10…+50 | 40°С
b078 | Сброс счетчика электроэнергии: - 00: нет сброса, - 01: сброс нажатием кнопки STR. | 00
b079 | Коэффициент отображения счетчика электроэнергии от 1 до 1000 | 1
b082 | Установка стартовой частоты, от 0.10 до 9.99Гц | 0.5Гц
b083 | Установка несущей частоты, от 0.5 до 15кГц | 2.0кГц
b084 | Режим инициализации (параметры или история сбоев): - 00: не происходит - 01: очистка истории сбоев, - 02: установка заводских параметров, - 03: очистка истории сбоев и установка заводских параметров, - 04: очистка истории сбоев и установка заводских параметров и сброс программы | 00
b085 | Код страны для инициализации: - 00: Япония / США, - 01: Европа | 00
b086 | Коэффициент масштабирования для отображаемой в d007 частоты, от 0.1 до 99.99 | 1.0
b087 | Действие кнопки STOP: - 00: действует, - 01: не действует, - 02: не действует только функция стоп, | 00
b088 | Режим перезапуска после FRS - 00: перезапуск с 0Гц, - 01: перезапуск с частоты определенной по реальной скорости мотора (подхват частоты), - 02: перезапуск с частоты определенной по реальной скорости мотора (активный подхват частоты), | 00
b089 | Автоматическое понижение несущей частоты: - 00: не действует, - 01: действует, зависит от выходного тока, - 02: действует, зависит от температуры, | 01
b090 | Значение использования тормозного устройства | 0%

29

код | | умолчанию | значение
b091 | Выбор способа остановки мотора: - 00: замедление по характеристике, - 01: FRS, свободный выбег, | 00
b092 | Работа вентиляторов охлаждения: - 00: работают всегда, - 01: работают при работе мотора, отключаются после 5 минут простоя мотора, - 02: работают по температуре, | 01
b093 | Сброс времени работы вентиляторов охлаждения: - 00: сброса нет, - 01: сброс, | 00
b094 | Инициализация параметров: - 00: все параметры, - 01: все параметры, кроме функций входов, выходов и коммуникационных, - 02: только параметры из Uxxx, - 03: все параметры, кроме Uxxx и b037 | 00
b095 | Работа тормозного устройства: - 00: не действует, - 01: действует только в режиме RUN, - 02: действует всегда, | 01
b096 | Уровень напряжения для активации тормозного устройства от 660 до 760 В, | 720В
b097 | Сопротивление тормозного резистора, подключенного к тормозному устройству | min Ом
b100 | Частота 1 для создаваемой V/f, от 0Гц до b102 | 0.
b101 | Напряжение 1 для создаваемой V/f, от 0 до 800В | 0.0
b102 | Частота 2 для создаваемой V/f, от 0Гц до b104 | 0.
b103 | Напряжение 2 для создаваемой V/f, от 0 до 800В | 0.0
b104 | Частота 3 для создаваемой V/f, от 0Гц до b106 | 0.
b105 | Напряжение 3 для создаваемой V/f, от 0 до 800В | 0.0
b106 | Частота 4 для создаваемой V/f, от 0Гц до b108 | 0.
b107 | Напряжение 4 для создаваемой V/f, от 0 до 800В | 0.0
b108 | Частота 5 для создаваемой V/f, от 0Гц до b110 | 0.
b109 | Напряжение 5 для создаваемой V/f, от 0 до 800В | 0.0
b110 | Частота 6 для создаваемой V/f, от 0Гц до b112 | 0.
b111 | Напряжение 6 для создаваемой V/f, от 0 до 800В | 0.0
b112 | Частота 7 для создаваемой V/f, от 0Гц до 400Гц | 0.
b113 | Напряжение 7 для создаваемой V/f, от 0 до 800В | 0.0
b120 | Режим управления тормозом: - 00: не действует, - 01: действует, | 00
b121 | Задержка наложения тормоза от 0.00 до 5.00 с | 0.00с
b122 | Задержка управления тормозом при разгоне от 0.00 до 5.00 с | 0.00с
b123 | Задержка управления тормозом при остановке от 0.00 до 5.00 с | 0.00с
b124 | Задержка управления тормозом при подтверждении от 0.00 до 5.00 с | 0.00с
b125 | Частота наложения тормоза, от 0.00 до 400Гц | 0.00
b126 | Ток наложения тормоза, от 0.0 до 2× ном. ток | Ном.ток
b127 | Частота торможения, от 0.00 до 400Гц | 0.00
b130 | Действие режима ограничения перегрузки по напряжению: - 00: не действует, - 01: действует, - 02: действует при разгоне, | 00
b131 | Напряжение ограничения перегрузки по напряжению, от 660 до 780В | 760В

30

код | | умолчанию | значение
b132 | Значение разгона и остановки для функции ограничения перегрузки по напряжению, от 0.1 до 30 с | 1.0с
b133 | Пропорциональная составляющая для функции ограничения перегрузки по напряжению, от 0.00 до 5 | 0.20
b134 | Интегральная составляющая для функции ограничения перегрузки по напряжению, от 0.000 до 150с | 1с
b145 | Режим входа GS: - 00: нет аварии, - 01: авария, | 00
b150 | Параметр, отображающийся на заблокированном встроенном дисплее, при подключении внешнего дисплея по RS422: 001=d001 … 030=d030 | 001
b160 | Первый параметр двойного монитора: 001=d001 … 030=d030 | 001
b161 | Второй параметр двойного монитора: 001=d001 … 030=d030 | 002
b163 | Задание частоты при отображении: - 00: не возможно, - 01: возможно, | 00
b164 | Автоматический возврат через 10мин к начальному дисплею, выбранному в b038: - 00: не возможен, - 01: возможен, | 00
b165 | Действие при потере связи/ сети: - 00: авария, - 01: авария после замедления и стопа, - 02: игнорирование, - 03: остановка на выбеге, FRS, - 04: замедление и стоп, | 02
b166 | Выбор записи/чтения данных: - 00: запись/чтение доступные, - 01: запись/чтение заблокированы | 00
b171 | Выбор режима инвертера: - 00: нет функции, - 01: стандартный индукционный мотор, - 02: мотор с постоянными магнитами | 00
b180 | Триггер, выпоняющий инициализацию с учетом b084, b085, b094: - 00: инициализация невозможна, - 01: инициализация выполниется,
b190 | Ввод пароля А от 0001 до FFFF, 0000-нет пароля | 0000
b191 | Подтверждение пароля А от 0000 до FFFF, | 0000
b192 | Ввод пароля В от 0001 до FFFF, 0000-нет пароля | 0000
b193 | Подтверждение пароля В от 0000 до FFFF, | 0000

31

## Группа параметров «С»:

Функциональный код | Наименование / Описание | Значение по умолчанию | Установленное значение
С001 | Функция входа [1] | Есть возможность присвоить данным входам по одной из 68 функций (см. стр. 40) | 00
С002 | Функция входа [2] | | 01
С003 | Функция входа [3], GS1-совместимый | | 02
С004 | Функция входа [4] ], GS2-совместимый | | 03
С005 | Функция входа [5] ], PTC-совместимый | | 09
С006 | Функция входа [6] | | 18
С007 | Функция входа [7] | | 13
С011 | Активное состояние входа [1] | - 00: нормально открытый [NO] - 01: нормально закрытый [NC] | 00
С012 | Активное состояние входа [2] | | 00
С013 | Активное состояние входа [3] | | 00
С014 | Активное состояние входа [4] | | 00
С015 | Активное состояние входа [5] | | 00
С016 | Активное состояние входа [6] | | 00
С017 | Активное состояние входа [7] | | 00
С021 | Функция выхода [11] ], EDM-совместимый | Есть возможность присвоить данным выходам по 1 из 48 функций, (см. стр. 41) | 01
С022 | Функция выхода [12] | | 00
С026 | Функция выхода реле аварийной сигнализации | | 05
С027 | Выбор сигнала для выхода [EO] | Есть возможность присвоить данному выходу 1 из 13 функции (см. стр. 42) | 07
С028 | Выбор сигнала для аналогового выхода [АМ] | Есть возможность присвоить данному выходу 1 из 11 функции (см. стр. 42) | 07

32

код | | умолчанию | значение
С030 | Ссылка на величину отображения тока, От 0.2×ном. ток до 2×ном. ток | Ном. ток
С031 | Активное состояние выхода [11] | - 00: нормально открытый [NO] - 01: нормально закрытый [NC] | 00
С032 | Активное состояние выхода [12] | | 00
С036 | Активное состояние выхода реле аварийной сигнализации | | 01
С038 | Выбор режима индикации о пониженном потребляемом токе: - 00: при разгоне, остановке и постоянной скорости, - 01: только при постоянной скорости, | | 01
С039 | Значение для режима индикации о пониженном потребляемом токе, от 0 до 2×ном.ток | | Ном. ток инвертора
С040 | Выбор режима индикации о повышенном потребляемом токе: - 00: при разгоне, остановке и постоянной скорости, - 01: только при постоянной скорости, | | 01
С041 / С241 | Значение для режима индикации о повышенном потребляемом токе, от 0 до 2×ном.ток | | Ном. ток инвертора
С042 | Установка значения достигнутой частоты при разгоне, от 0 до 400Гц | | 0.00Гц
С043 | Установка значения достигнутой частоты при замедлении, от 0 до 400Гц | | 0.00Гц
С044 | Установка превышения уровня допустимой ошибки ПИД-регулирования | | 3.0%
С045 | Установка значения достигнутой частоты 2 при разгоне, от 0 до 400Гц | | 0.00Гц
С046 | Установка значения достигнутой частоты 2 при замедлении, от 0 до 400Гц | | 0.00Гц
С047 | Масштабирование последовательности импульсов на входе/выходе, если ЕО-импульсный вход (С027=15) то Имп.Выход=Имп.Вход х С047 | | 1
С052 | Верхнее ограничение для выхода ПИД | | 100.0%
С053 | Нижнее ограничение для выхода ПИД | | 0.0%
С054 | Выбор крутящего момента: - 00: превышение, - 01: недостаток, | | 00
С055 | Значение крутящего момента, движение вперед, от 0 до 200 % | | 100%
С056 | Значение крутящего момента, движение назад с регенерацией, от 0 до 200 % | | 100%
С057 | Значение крутящего момента, движение назад, от 0 до 200 % | | 100%
С058 | Значение крутящего момента, движение вперед с регенерацией, от 0 до 200 % | | 100%
С059 | Выходной сигнал превышения/недостатка момента: - 00: при разгоне замедлении и пост. скорости, - 01: только при постоянной скорости, | | 01
С061 | Значение электронного термодатчика для предупреждения, от 0 до 100% | | 90%

33

код | | умолчанию | значение
С063 | Уровень определения нулевой скорости, от 0.00 до 100.0Гц | 0.00Гц
С064 | Уровень перегрева радиатора для предупреждения, от 0 до 200.0°С | 100°С
С071 | Выбор скорости связи: - 03: 2400 бит/с, - 04: 4800 бит/с, - 05: 9600 бит/с, - 06: 19200 бит/с, - 07: 38400 бит/с, - 08: 76800 бит/с, - 09: 115200 бит/с, | 05
С072 | Позиционный адрес в сети ModBus, от 1 до 247 | 1.
С074 | Выбор четности связи - 00: нет равенства - 01: чётное равенство - 02: нечётное равенство | 00
С075 | Выбор стопового бита связи: - 1: 1 бит, - 2: 2 бита, | 1
С076 | Выбор действия при ошибке связи: - 00: авария, - 01: замедление до полной остановки и авария, - 02: игнорирование, - 03: остановка свободным выбегом (FRS), - 04: замедление до полной остановки, | 02
С077 | Тайм-аут ошибки связи, от 0.00 до 99.99 с | 0.00
С078 | Время ожидания связи, от 0 до 1000 мс | 0.
С081 | Калибровка входа [О], от 0 до 200% | 100%
С082 | Калибровка входа [OI], от 0 до 200% | 100%
С085 | Настройка входа термистора, от 0.0 до 200% | 100%
С091 | Режим отладки – не изменять этот параметр | 00
С096 | Выбор связи: - 00: ModBus RTU, - 01: EzCOM, - 02: EzCOM<administrator> | 00
C098 | EzCOM начальный адрес мастера: 01-08 | 01
C099 | EzCOM конечный адрес мастера: 01-08 | 01
С100 | EzCOM триггер старта - 00: терминал входов, - 01: всегда | 00
С101 | Выбор запоминания для функции Up/Down: - 00: сброс последнего значения частоты (возврат к значению в F001), - 01: запоминать последнее значение частоты, набранное UP/DWN | 00
С102 | Выбор действия клеммы [RS] Сброс: - 00: сброс аварии подачей сигнала (+ фронт), стоп мотора если режим RUN, - 01: сброс аварии снятием сигнала (- фронт), стоп мотора если режим RUN, - 02: сброс аварии подачей сигнала (+ фронт), не влияет на мотор если режим RUN, - 03: очистка памяти, относящейся к аварии | 00
С103 | Перезапуск после Сброса: - 00: Старт с 0Гц, - 01: Старт с подхватом частоты, - 02: Старт с активным подхватом частоты | 00

34

код | | умолчанию | значение
С104 | Режим очистки значения для функции UP/DWN при подаче сигнала UDC: - 00: 0Гц, - 01: значение, сохраненное в памяти при включении, | 00
С105 | Установка поправки ЕО, от 50 до 200% | 100.
С106 | Установка поправки АM, от 50 до 200% | 100.
С109 | Установка базового значения АM, от 0 до 100% | 0.
С111 | Установка 2 перегрузки по току, От 0.0 до 2×ном.ток | Ном.ток × 1.15
С130 | Задержка включения выхода 11, от 0.0 до 100.0с | 0.0
С131 | Задержка выключения выхода 11, от 0.0 до 100с | 0.0
С132 | Задержка включения выхода 12, от 0.0 до 100.0с | 0.0
С133 | Задержка выключения выхода 12, от 0.0 до 100с | 0.0
С140 | Задержка включения выхода AL, от 0.0 до 100с | 0.0
С141 | Задержка выключения выхода AL, от 0.0до 100с | 0.0
С142 | Логический выход 1 операнд А, настройка такая же, как С021-С026 (кроме LOG1-LOG3, ОРО, no) | 00
С143 | Логический выход 1 операнд Б, настройка такая же, как С021-С026 (кроме LOG1-LOG3, ОРО, no) | 00
С144 | Логическое действие для логического выхода 1: - 00: [LOG]= А and Б, - 01: [LOG]= А or Б, - 02: [LOG]= А xor Б, | 00
С145 | Логический выход 2 операнд А, настройка такая же, как С021-С026 (кроме LOG1-LOG3, ОРО, no) | 00
С146 | Логический выход 2 операнд Б, настройка такая же, как С021-С026 (кроме LOG1-LOG3, ОРО, no) | 00
С147 | Логическое действие для логического выхода 2: - 00: [LOG]= А and Б, - 01: [LOG]= А or Б, - 02: [LOG]= А xor Б, | 00
С148 | Логический выход 3 операнд А, настройка такая же, как С021-С026 (кроме LOG1-LOG3, ОРО, no) | 00
С149 | Логический выход 3 операнд Б, настройка такая же, как С021-С026 (кроме LOG1-LOG3, ОРО, no) | 00
С150 | Логическое действие для логического выхода 3: - 00: [LOG]= А and Б, - 01: [LOG]= А or Б, - 02: [LOG]= А xor Б, | 00
С160 | Время отклика входа 1, от 0 до 200 (×2мс) | 1
С161 | Время отклика входа 2, от 0 до 200 (×2мс) | 1
С162 | Время отклика входа 3, от 0 до 200 (×2мс) | 1
С163 | Время отклика входа 4, от 0 до 200 (×2мс) | 1
С164 | Время отклика входа 5, от 0 до 200 (×2мс) | 1
С165 | Время отклика входа 6, от 0 до 200 (×2мс) | 1
С166 | Время отклика входа 7, от 0 до 200 (×2мс) | 1
С169 | Время определения многоэтапной скорости/ позиции, от 0 до 200 (×10мс) | 0

35

## Группа параметров «Н»: характеристики двигателя

Функциональный код | Наименование / Описание | Значение по умолчанию | Установленное значение
Н001 | Установка метода автонастройки: - 00: без автонастройки, - 01: автонастройка без вращения двигателя, - 02: автонастройка с вращением двигателя, | 00
Н002 / Н202 | Выбор параметров для 1-го/2-го двигателя: - 00: стандартный двигатель HITACHI, - 01: данные автонастройки, | 00
Н003 / Н203 | Мощность двигателя | Заводское зн.
Н004 / Н204 | Установка числа полюсов двигателя: 2 / 4 / 6 / 8 / 10 | 4
Н005 / Н205 | Oтклик скорости мотора, от 1 до 1000% | 100
Н006 / Н206 | Константа стабилизации мотора, от 0 до 255 | 100.
Н020 / Н220 | Значение R1 мотора, от 0.001 до 65.535 Ом | Заводское зн.
Н021 / Н221 | Значение R2 мотора, от 0.001 до 65.535 Ом | Заводское зн.
Н022 / Н222 | Значение L мотора, от 0.01 до 655.35 мГн | Заводское зн.
Н023 / Н223 | Значение I0 мотора, от 0.01 до 655.35 A | Заводское зн.
Н024 / Н224 | Значение J мотора, от 0.001 до 9999кгм² | Заводское зн.
Н030 / Н230 | Автонастройка параметра R1, от 0.001 до 65.535 Ом | Заводское зн.
Н031 / Н231 | Автонастройка параметра R2, от 0.001 до 65.535 Ом | Заводское зн.
Н032 / Н232 | Автонастройка параметра L, от 0.01 до 655.35 Ом | Заводское зн.
Н033 / Н233 | Автонастройка параметра I0, от 0.01 до 655.35 A | Заводское зн.
Н034 / Н234 | Автонастройка параметра J, от 0.001 до 9999 | Заводское зн.
Н050 | PI пропорциональная составляющая компенсации скольжения, от 0.0 до 10 | 0.2
Н051 | PI интегральная составляющая, от 0.0 до 1000 | 2
Параметры мотора с постоянными магнитами
H102 | Выбор параметров двигателя: - 00: стандартный двигатель HITACHI (исп. параметры 106-110), - 01: данные автонастройки (исп. параметры 109-110 и 111-113), | 00
Н103 | Мощность двигателя | Заводское зн.
Н104 | Установка числа полюсов двигателя: 2 / … / 48 | Заводское зн.
Н105 | Номинальный ток | Заводское зн.
Н106 | Значение R мотора, от 0.001 до 65.535 Ом | Заводское зн.
Н107 | Значение Ld мотора, от 0.01 до 655.35 мГн | Заводское зн.
Н108 | Значение Lq мотора, от 0.01 до 655.35 мГн | Заводское зн.
Н109 | Значение Ке мотора, от 0.0001 до 6.5535 V/(rad/s) | Заводское зн.
Н110 | Значение J мотора, от 0.001 до 9999кгм² | Заводское зн.
Н111 | Значение R мотора, от 0.001 до 65.535 Ом | Заводское зн.
Н112 | Значение Ld мотора, от 0.01 до 655.35 мГн | Заводское зн.
Н113 | Значение Lq мотора, от 0.01 до 655.35 мГн | Заводское зн.
Н116 | Oтклик скорости мотора, от 1 до 1000% | 100
Н117 | Стартовый ток, 20.00 – 100.00% | 70.00
Н118 | Стартовое время, 0.01 – 60.00 с | 1
Н119 | Постоянная стабилизации, 0 - 120% | 100
Н121 | Минимальная частота, 0.0 – 25.5 | 8

36

код | | умолчанию | значение
Н122 | Ток холостого хода, 0.00 – 100.00% | 10
Н123 | Метод старта: - 00: нормальный, - 01: оценка начального положения магнита, | 00
Н131 | Оценка начального положения магнита 0V, время ожидания, 0 - 255 | 10
Н132 | Определение начального положения магнита, время ожидания, 0 - 255 | 10
Н133 | Оценка начального положения магнита, время определения, 0 - 255 | 30
Н134 | Оценка начального положения магнита, коэффициент напряжения, 0 - 200 | 100

## Группа параметров «Р»: функции карт расширения

Функциональный код | Наименование / Описание | Значение по умолчанию | Установленное значение
Р001 | Действие при отказе дополнительной карты 1: - 00: авария инвертора, - 01: игнорирование аварии, инвертор продолжает работу, | 00
Р003 | Выбор функции входа ЕА: - 00: задание скорости (включая ПИД), - 01: для обратной связи с энкодером, - 02: расширенный терминал для EzSQ | 00
Р004 | Выбор режима последовательности импульсов для обратной связи: - 00: однофазные импульсы (ЕА), - 01: двухфазные импульсы 1 со сдвигом 90° (ЕА и ЕВ), - 02: двухфазные импульсы 2 со сдвигом 90° (ЕА и ЕВ), - 03: однофазные импульсы (ЕА) и сигнал направления (ЕВ) | 00
Р011 | Количество импульсов энкодера, 32 - 1024 | 512
Р012 | Выбор простого позиционирования: - 00: простое позиционирование неактивно, - 01: простое позиционирование активно, | 00
Р015 | Скорость стартовая Creep, b082 – 10Гц | 5
Р026 | Уровень ошибки определения превышения скорости, 0 – 150% | 115
Р027 | Уровень ошибки определения девиации скорости, 0 – 120Гц | 10

Р031
Р033 | Выбор входа задания момента: - 00: вход О, - 01: вход OI, -03: оператор, - 06: опция, | 00
Р034 | Уровень задания момента, 0 – 200% | 0
Р036 | Способ смещения момента: - 00: нет смещения, - 01: оператор, | 00
Р037 | Значение смещения момента, -200 – 200% | 00

37

код | | умолчанию | значение
Р038 | Полярность смещения момента: - 00: согласно знаку, - 01: согласно направлению вращения, - 05: опция, | 00
Р039 | Ограничение скорости для контроля момента (прямое вращение), 0.00 – 120.00Гц | 0.00
Р040 | Ограничение скорости для контроля момента (прямое вращение), 0.00 – 120.00Гц | 0.00
Р041 | Контроль скорости / контроль момента время переключения, 0 – 1000мс | 0
Р044 | Сетевой сторожевой таймер (для опции), 0 – 99с | 1.00
Р045 | Действие при ошибке связи (для опции): - 00: авария инвертора, - 01: авария после замедления и стопа мотора, - 02: игнорирование аварии, - 03: выбег мотора и стоп, - 04: замедление и стоп мотора, | 00
Р046 | Polled I/O output instance number, 0 - 20 | 1
Р048 | Inverter action on communication idle mode: - 00: авария инвертора, - 01: авария после замедления и стопа мотора, - 02: игнорирование аварии, - 03: выбег мотора и стоп, - 04: замедление и стоп мотора, | 00
Р049 | Установка числа полюсов двигателя для отображения оборотов в минуту: 0 / … / 48 | 0
Р055 | Установка максимальной частоты для импульсного входа: 1 – 32кГц | 25
Р056 | Постоянная времени фильтра импульсного входа: 0.01 – 2.00с | 0.1с
Р057 | Установка смещения для импульсного входа: -100 – 100% | 0
Р058 | Установка ограничения для импульсного входа: 0 – 100% | 100
Р060 | Многоступенчатая позиция 0: от Р073 до Р072 (отображаются только 4 старших разряда) | 0
Р060 | Многоступенчатая позиция 0: от Р073 до Р072 | 0
Р061 | Многоступенчатая позиция 1: от Р073 до Р072 | 0
Р062 | Многоступенчатая позиция 2: от Р073 до Р072 | 0
Р063 | Многоступенчатая позиция 3: от Р073 до Р072 | 0
Р064 | Многоступенчатая позиция 4: от Р073 до Р072 | 0
Р065 | Многоступенчатая позиция 5: от Р073 до Р072 | 0
Р066 | Многоступенчатая позиция 6: от Р073 до Р072 | 0
Р067 | Многоступенчатая позиция 7: от Р073 до Р072 | 0
Р068 | Режим возврата: - 00: на низкой скорости, - 01: на высокой скорости, | 00
Р069 | Направление возврата: - 00: прямое вращение, - 01: обратное вращение, | 01
Р070 | Частота низкой скорости возврата: 0 – 10Гц | 5
Р071 | Частота высокой скорости возврата: 0 – 400Гц | 5
Р072 | Диапазон позиции в прямом направлении: 0 … +268435455 (отобр. старшие 4 разряда) | +268435455
Р073 | Диапазон позиции в обратном направлении: -268435455…0 (отобр. старшие 4 разряда) | -268435455
Р075 | Режим позиционирования: - 00: с ограничением, - 01: без ограничения, Р004 = 00 или 01, | 00

38

код | | умолчанию | значение
Р077 | Время отключенного энкодера: 0 – 10с | 1
Р100 – Р131 | Параметры пользователя в ПО EzSQ: U(00) – U(31) | 0
Р040 | EzCOM номер данных: 0 - 5 | 5
Р041 | EzCOM расположение 1, адрес: 1 - 247 | 1
Р042 | EzCOM расположение 1, регистр: 0000 - FFFF | 0000
Р043 | EzCOM источник 1, регистр: 0000 - FFFF | 0000
Р044 | EzCOM расположение 2, адрес: 1 - 247 | 2
Р045 | EzCOM расположение 2, регистр: 0000 - FFFF | 0000
Р046 | EzCOM источник 2, регистр: 0000 - FFFF | 0000
Р047 | EzCOM расположение 3, адрес: 1 - 247 | 3
Р048 | EzCOM расположение 3, регистр: 0000 - FFFF | 0000
Р049 | EzCOM источник 3, регистр: 0000 - FFFF | 0000
Р050 | EzCOM расположение 4, адрес: 1 - 247 | 4
Р051 | EzCOM расположение 4, регистр: 0000 - FFFF | 0000
Р052 | EzCOM источник 4, регистр: 0000 - FFFF | 0000
Р053 | EzCOM расположение 1, адрес: 1 - 247 | 5
Р054 | EzCOM расположение 1, регистр: 0000 - FFFF | 0000
Р055 | EzCOM источник 1, регистр: 0000 - FFFF | 0000

## Внимание, это важно!!!

## Подробное описание всех указанных, а также специальных параметров и функций представлено в полной версии инструкции по

эксплуатации данного оборудования.

## (смотрите на CD в комплекте поставки или спрашивайте у поставщика)

39

## Функции программируемых дискретных входов

Обозначение | Код | Наименование клеммы
FW | 00 | Прямое вращение, 2-позиц. переключатель с фиксацией (Пуск/Стоп)
RV | 01 | Обратное вращение, 2-позиц. переключатель с фиксацией (Пуск/Стоп)
CF1 | 02 | Режим ступенчатого задания скорости, бит 0
CF2 | 03 | Режим ступенчатого задания скорости, бит 1
CF3 | 04 | Режим ступенчатого задания скорости, бит 2
CF4 | 05 | Режим ступенчатого задания скорости, бит 3
JG | 06 | Режим JOG
DB | 07 | Динамическое торможение
SET | 08 | Установка (выбор) параметров для второго двигателя
2CH | 09 | Второй этап разгона и торможения
FRS | 11 | Останов свободным выбегом
EXT | 12 | Сбой во внешней цепи
USP | 13 | Предотвращение перезапуска
CS | 14 | Переключение мотора на сеть
SFT | 15 | Блокировка изменения параметров
AT | 16 | Выбор аналогового входного сигнала (напряжение/ток)
SET3 | 17 | Установка (выбор) параметров для третьего двигателя
RS | 18 | Сброс
РТС | 19 | Термистор с положительным ТК
STA | 20 | Старт кнопка НО без фиксации (3-проводное управление)
STP | 21 | Стоп кнопка НЗ без фиксации (3-проводное управление)
F/R | 22 | Прямое или обратное вращение (3- проводное управление)
PID | 23 | Отключение ПИД-регулятора
PIDC | 24 | Сброс интегральной составляющей ПИД-регулятора
UP | 27 | Повышение частоты удаленной кнопкой
DWN | 28 | Уменьшение частоты удаленной кнопкой
UDC | 29 | Сброс набранной кнопками частоты
OPE | 31 | Принудительное управление с панели преобразователя
SF1 | 32 | Фиксированные скорости 1 (битовая установка)
SF2 | 33 | Фиксированные скорости 2 (битовая установка)
SF3 | 34 | Фиксированные скорости 3 (битовая установка)
SF4 | 35 | Фиксированные скорости 4 (битовая установка)
SF5 | 36 | Фиксированные скорости 5 (битовая установка)
SF6 | 37 | Фиксированные скорости 6 (битовая установка)
SF7 | 38 | Фиксированные скорости 7 (битовая установка)
OLR | 39 | Переключение пределов срабатывания для функции защиты от перегрузки по току
TL | 40 | Включение ограничителя момента
TRQ1 | 41 | Включение ограничения момента 1
TRQ2 | 42 | Включение ограничения момента 2
BOK | 44 | Подтверждение тормоза
LAC | 46 | Заданные времена линейного разгона/торможения не учитываются. Выход преобразователя частоты без задержки повторяет заданную скорость вращения. Отмена LAD
PCLR | 47 | Сброс счетчика импульсов
ADD | 50 | Возможность прибавить частоту
F-TM | 51 | Режим принудительного управления с клемм
ATR | 52 | Разрешение для входа задания момента
KHC | 53 | Сброс счетчика электроэнергии
MI1 | 56 | Вход 1 общего назначения для программы EzSQ
MI2 | 57 | Вход 2 общего назначения для программы EzSQ
MI3 | 58 | Вход 3 общего назначения для программы EzSQ
MI4 | 59 | Вход 4 общего назначения для программы EzSQ
MI5 | 60 | Вход 5 общего назначения для программы EzSQ
________________________________________________________________________ 40

Обозначение | Код | Наименование клеммы
MI6 | 61 | Вход 6 общего назначения для программы EzSQ
MI7 | 62 | Вход 7 общего назначения для программы EzSQ
AHD | 65 | Фиксация аналогового задания
CP1 | 66 | Выбор значения 1 многоступенчатого позиционирования
CP2 | 67 | Выбор значения 2 многоступенчатого позиционирования
CP3 | 68 | Выбор значения 3 многоступенчатого позиционирования
ORL | 69 | Функция ограничения возврата в нулевую точку
ORG | 70 | Функция запуска возврата в нулевую точку
SPD | 73 | Переключение ррегулирования скорость / позиционирование
GS1 | 77 | Вход STO1 (Сигнал функции безопасности)
GS2 | 78 | Вход STO2 (Сигнал функции безопасности)
485 | 81 | Запуск обмена данными «инвертор-инвертор»
PRG | 82 | Выполнение программы EzSQ
HLD | 83 | Сохранение выходной частоты
ROK | 84 | Разрешение команды «Пуск»
EB | 85 | Определение направления вращения для канала В
DISP | 86 | Ограничение отображения
NO | 255 | Функцыя не назначена

## Функции программируемых дискретных/ релейных выходов

Обозначение | Код | Наименование клеммы
RUN | 00 | Сигнал о запуске двигателя
FA1 | 01 | Достижение частоты 1-го типа – постоянная частота
FA2 | 02 | Достижение частоты 2-го типа – диапазон частот
OL | 03 | Сигнал предварительного уведомления о перегрузке
OD | 04 | Выходное отклонение для ПИД-регулирования
AL | 05 | Сигнал об аварии
FA3 | 06 | Сигнал при работе на участках постоянной выходной частоты
OTQ | 07 | Сигнал повышенного/ пониженного момента
IP | 08 | Сигнал при кратковременном пропадании напряжения питания
UV | 09 | Пониженное напряжение
TRQ | 10 | Ограничение момента
RNT | 11 | Сигнал при достижении установленного суммарного времени работы
ONT | 12 | Сигнал при достижении установленного суммарного времени подключения к питающей сети
THM | 13 | Сигнал о превышении установленного уровня температуры
BRK | 19 | Сигнал отпускания тормоза
BER | 20 | Сигнал аварии тормоза
ZS | 21 | Сигнал обнаружения нулевой скорости
DSE | 22 | Сигнал о чрезмерной девиации скорости
POC | 23 | Сигнал завершения позиционирования
FA4 | 24 | Сигнал при работе в заданном диапазоне частот 2
FA5 | 25 | Сигнал при работе на участках постоянной выходной частоты 2
OL2 | 26 | Сигнал предупреждения о перегрузке 2
ODc | 27 | Определение обрыва аналогового сигнала О
OIDc | 28 | Определение обрыва аналогового сигнала ОI
O2Dc | 29 | Определение обрыва аналогового сигнала О2
FBV | 31 | Выход второй ступени ПИД-регулирования
NDc | 32 | Отключение линии связи RS485
LOG1 | 33 | Результат логической операции 1
LOG2 | 34 | Результат логической операции 2
LOG3 | 35 | Результат логической операции 3
WAC | 39 | Предупреждение о проблеме с конденсаторами
WAF | 40 | Предупреждение о проблеме с вентиляторами
FR | 41 | Сигнал наличия команды Пуск
OHF | 42 | Предупреждение о перегреве радиатора

41

Обозначение | Код | Наименование клеммы
LOC | 43 | Сигнал предупреждения о пониженном потребляемом токе
M01 | 44 | Выход 1 общего назначения для программы EzSQ
M02 | 45 | Выход 2 общего назначения для программы EzSQ
M03 | 46 | Выход 3 общего назначения для программы EzSQ
IRDY | 50 | Инвертор готов
FWR | 51 | Вращение в прямом направлении
RVR | 52 | Вращение в обратном направлении
MJA | 53 | Сигнал серьезной неисправности
WCO | 54 | Сигнал компаратора аналогового сигнала О
WCOI | 55 | Сигнал компаратора аналогового сигнала ОI
FREF | 58 | Источник задания частоты
REF | 59 | Источник команды «Пуск»
SETM | 60 | Выбраны настройки второго мотора
EDM | 62 | Контроль безопасного снятия момента (STO) (только выход 11)
OP | 63 | Дополнительный сигнал управления
NO | 255 | Не задана функция

## Перечень функций импульсного аналогового выхода [ЕО] (импульсный/ШИМ выход)

Код опции С027 | Наименование функции

00 Отображение частоты
01 Отображение выходного тока
02 Отображение выходного момента
03 Цифровое отображение частоты
04 Отображение выходного напряжения 05 Отображение выходной мощности 06 Значение электронного теплового реле 07 Частота линейного профиля LAD
08 Цифровое отображение тока
10 Температура радиатора
12 Выход YA(0) общего назначения для программы EzSQ
15 См. параметр С047, С105
16 Опция

## Перечень функций аналогового выхода [AM] (аналоговый выход напряжения 0...10В, 1мА)

Код опции С027 | Наименование функции

00 Отображение частоты
01 Отображение выходного тока
02 Отображение выходного момента
04 Отображение выходного напряжения 05 Отображение выходной мощности 06 Значение электронного теплового реле 07 Частота линейного профиля LAD
10 Температура радиатора
11 Выходной момент (со знаком)
13 Выход YA(1) общего назначения для программы EzSQ 16 Опция

42
