pav2000/ControlHeatPump2.0/Nextion/3D_model/4.3-Bezel.STL

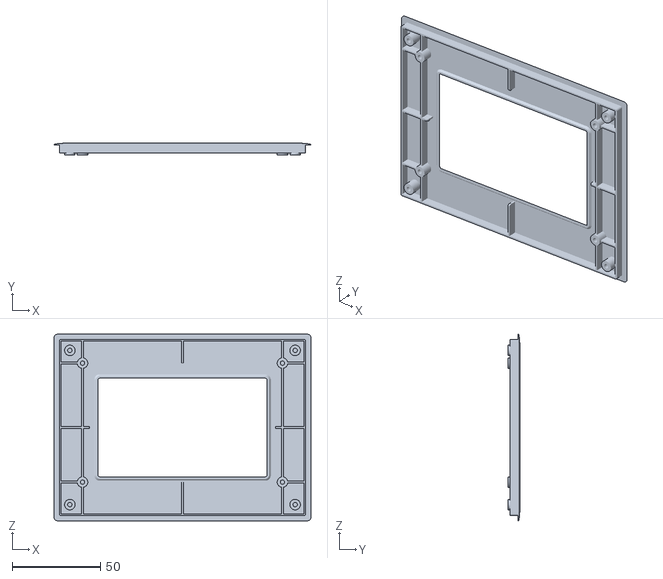
[picture p34: CAD file, 2026-10-21]
Nextion/3D_model/4.3-Bezel.STL
146.0 x 6.80 x 106.0
