pav2000/ControlHeatPump2.0/Nextion/3D_model/Дно 4.3.stl

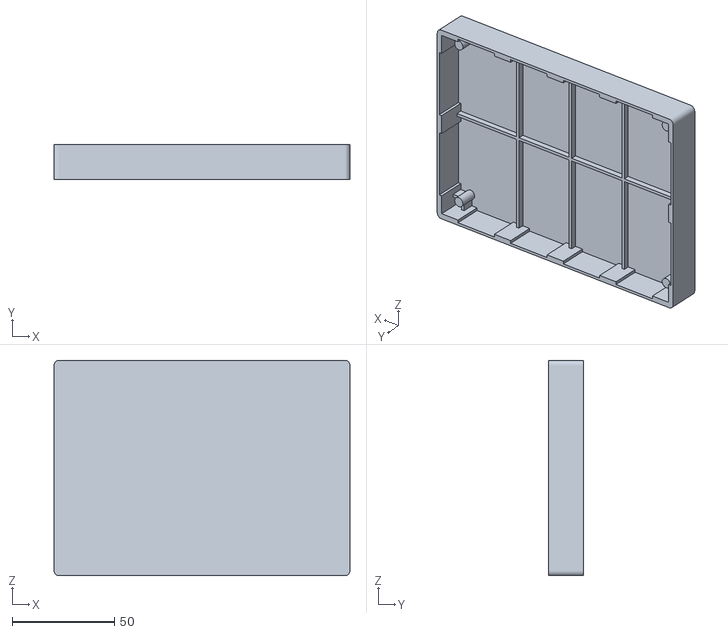
[picture p35: CAD file, 2026-10-21]
Nextion/3D_model/Дно 4.3.stl
145.0 x 17.0 x 105.5
