pav2000/ControlHeatPump2.0/Nextion/3D_model/4.3-Display.STL

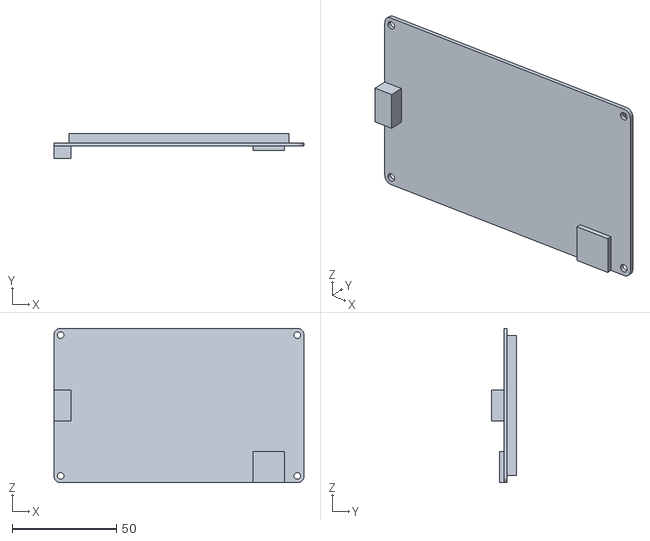
[picture p36: CAD file, 2026-10-21]
Nextion/3D_model/4.3-Display.STL
120.0 x 12.2 x 74.0
