pav2000/ControlHeatPump2.0/Control/Config.h

#define Config_h
#include "src/log/RingChart.h"
#include <Ethernet.h>              // Нужна для определения SPI_RATE в w5100.h
constexpr bool PRESS_PROT_LOW_ENABLED = false;  // Включить после проверки PEVA и выдержек на ТН.
constexpr bool PRESS_PROT_HIGH_ENABLED = false; // Включить при установленном и проверенном PCON.
constexpr int PRESS_PROT_LOW_CBAR = 400;        // Останов при ≤ 4,00 бар избыточного давления.
constexpr int PRESS_PROT_HIGH_CBAR = 2200;      // Предварительный порог останова ≥ 22,00 бар.
constexpr int PRESS_PROT_LOW_RECOVER_CBAR = 430;  // Пробная граница восстановления низкого давления.
constexpr int PRESS_PROT_HIGH_RECOVER_CBAR = 2100; // Пробная граница допуска после аварии, давление должно быть ниже.
constexpr unsigned long PRESS_PROT_LOW_STABILIZE_MS = 60000UL; // Пробная задержка после пуска и смены режима.
constexpr unsigned long PRESS_PROT_LOW_CONFIRM_MS = 12000UL;  // Пробная выдержка низкого давления.
constexpr unsigned long PRESS_PROT_HIGH_CONFIRM_MS = 4000UL;  // Пробная выдержка высокого давления, включая пуск.
constexpr bool SUPERHEAT_WARN_ENABLED = true;             // Наблюдать перегрев на всасывании.
constexpr int SUPERHEAT_LOW_CK = 200;                     // Нижний порог предупреждения ≤ 2,00 K.
constexpr int SUPERHEAT_HIGH_CK = 1400;                   // Верхний порог предупреждения ≥ 14,00 K.
constexpr unsigned long SUPERHEAT_LOW_CONFIRM_MS = 60000UL;   // Выдержка нижнего порога.
constexpr unsigned long SUPERHEAT_HIGH_CONFIRM_MS = 180000UL; // Выдержка верхнего порога.
constexpr unsigned long SUPERHEAT_STABILIZE_MS = 300000UL; // Пробные 5 минут после пуска и смены режима.
constexpr int SUPERHEAT_HYSTERESIS_CK = 50;                // Пробный отступ 0,50 K для завершения эпизода.
constexpr bool BOILER_TEMP_INTERLOCK_ENABLED = true; // Отключать ТЭН по действующему максимуму TBOILER.
constexpr int BOILER_TEMP_RECOVER_MARGIN_CC = 50;    // Отступ восстановления от максимума, 0,50 °C.
constexpr bool MQTT_WARN_ENABLED = true;    // Предупреждать по действующему MQTT_NUM_ERR_OFF.
constexpr bool NOTIFY_WARN_ENABLED = true;  // Предупреждать при первом окончательном отказе по каналу.
constexpr bool TIME_WARN_ENABLED = true;    // Следить за достоверностью часов.
constexpr unsigned TIME_UNTRUSTED_CONFIRM_S = 300; // Выдержка без достоверного времени.
constexpr bool HEAP_LOW_WARN_ENABLED = true;       // Наблюдать запас свободной памяти.
constexpr int HEAP_LOW_BYTES = 4096;                // Предупреждение при запасе ниже 4 КиБ.
constexpr int HEAP_RECOVER_BYTES = 6144;            // Восстановление при запасе от 6 КиБ.
constexpr unsigned HEAP_LOW_CONFIRM_S = 60;        // Выдержка низкого запаса.
constexpr unsigned HEAP_RECOVER_CONFIRM_S = 60;    // Выдержка восстановления.
constexpr bool IO_BUS_WARN_ENABLED = true;          // Наблюдать устойчивые сбои SPI/DMA.
constexpr unsigned IO_BUS_WINDOW_S = 60;            // Длительность окна наблюдения.
constexpr unsigned IO_BUS_TIMEOUT_LIMIT = 3;        // Порог таймаутов шины за окно.
constexpr unsigned IO_DMA_TIMEOUT_LIMIT = 3;        // Порог таймаутов DMA за окно.
constexpr unsigned IO_DMA_OVERRUN_LIMIT = 3;        // Порог переполнений приёмника за окно.
constexpr unsigned IO_BAD_WINDOWS = 2;              // Число окон подряд по одному счётчику.
static_assert(PRESS_PROT_LOW_CBAR < PRESS_PROT_LOW_RECOVER_CBAR &&
              PRESS_PROT_LOW_RECOVER_CBAR < PRESS_PROT_HIGH_RECOVER_CBAR &&
              PRESS_PROT_HIGH_RECOVER_CBAR < PRESS_PROT_HIGH_CBAR, "Invalid pressure thresholds");
static_assert(SUPERHEAT_LOW_CK < SUPERHEAT_HIGH_CK, "Invalid superheat thresholds");
static_assert(SUPERHEAT_HYSTERESIS_CK > 0 &&
              2 * SUPERHEAT_HYSTERESIS_CK < SUPERHEAT_HIGH_CK - SUPERHEAT_LOW_CK,
              "Invalid superheat hysteresis");
static_assert(HEAP_LOW_BYTES < HEAP_RECOVER_BYTES, "Invalid free memory thresholds");
#define RELAY_ALL_OFF_ON_STOP       // Выключать ВСЕ реле при остановке ТН (StopWait),
#define MAIL_STATE_WIDE_FORMAT      // Расширенный формат письма о состоянии:
#ifdef BOARD_STAND
#define TEST_WATCHDOG               // Действие API test.wdt (p - номер задачи из Watchdog.h, -1 - отменить)
#endif
#define ONLY_HEAT                   // ТН работает ТОЛЬКО на отопление: режим "Охлаждение" недоступен
#define HTTP_TIME_REQ "/curr_time.csv"  // HTTP_TIME_REQUEST: файл на сервере времени, формат «<время UTC>;»
#ifdef BOARD_STAND
#define DEMO                                                              // Демо режим: подменные датчики и инвертор (профиль стенда)
#endif
#define CONFIG_NAME   "pav2000inv"                                        // Имя конфигурации
#define CONFIG_NOTE   "Инвертор с компрессором BLDC с шаговым ЭРВ и РТО"  // Описание конфигурации
#define HP_SCHEME       2                                                 // Номер схемы который выводится на морде, подмена файлов plan[HPscheme].png -> plan1.png
#define NEXTION                                                           // Разрешить использование дисплея ЗАКОМЕНТИРУЙТЕ эту строку что бы не использовать дисплей
	#define NEXTION_GENERATOR                                             // Показ на nextion кнопки "Работа от генератора" (ограничение мощности потребления)
extern uint8_t SPI_RATE;	// объявлен также в Libraries/Ethernet/utility/w5100.h
#ifdef CONFIG_DEFINE_OBJECTS
uint8_t SPI_RATE 	 = 2;	                                              // делитель для SPI шины, (2=42MHz, 3=28MHz, 4=21MHz) единый для ВСЕХ устройств
#endif
#define SD_CLOCK     30	                                                  // частота SPI для SD карты в МГц (работало 28)
     #define ONEWIRE_DS2482                                               // Использование мастера i2c Onewire DS2482 (адрес AD0 = 0)
    #define NO_SD_CONTROL                                                 // Использование выхода для контроля вставленной SD карты
    #define SPI_FLASH                                                     // Наличие чипа флеш памяти на шине SPI
    #define DRV_EEV_L9333                                                 // Драйвера ЭРВ L9333  диагностика
    #define KEY_ON_OFF                                                    // KEY1 Наличие кнопки включения/выключения ТН. Выбор режима загрузки этой же кнопкой работает БЕЗ признака
    #define LOAD_VERIFICATION                                             // Признак чтения настроек c проверкой версии, длины, CRC16. Закоментируйте эту строку для ПОПЫТКИ загрузить старый формат, Запись всегда идет в новом
    #define MODBUS_TIME_TRANSMISION 1                                     // пауза перед чтением обратно после modbus.write, x10 мс (api_modbus); на обмен с устройствами не влияет
#ifdef BOARD_STAND
    #define I2C_FRAM_128KB                   // FM24V10,  128 КБ, 0x50 + 0x51 - стенд
#else
    #define I2C_EEPROM_64KB                  // AT24C512,  64 КБ, 0x50        - рабочий ТН
#endif
     #define USE_ELECTROMETER_SDM               // Наличие счетчика SDM120 в конфигурации
     #define SDM_BLOCK                          // Блокировать чтение счетчика при потере связи, в противном случае будут периодически делаться попытки восстановить связь
     #define SDM_MIN_VOLTAGE     170.0          // Минимальное напряжение работы ТН при падении - предупреждение
     #define SDM_MAX_VOLTAGE     250.0          // Максимальное напряжение работы ТН при падении - выключение ТН
     #define SDM_MAX_POWER       2500.0         // Максимальная мощность потребления (ватт) - выключение ТН
	#define EXTERNAL_AREF                       // Использование внешней опоры для АЦП (ADR4525ARZ) требует доработки DUE и поддержки платы
	   #define SAM3X_ADC_REF  2.5006            // Используется внешняя опора ADR4525ARZ плата pav2000 (UT71E результататы ЗИП 2.4997 ТН 2.5006)
	#define POWER_CONTROL                       // Использование выхода для управления питанием платы (можно сбросить все кроме контроллера)
	#define VCC_CONTROL                         // Контроль за питанием контрола (прямое чтение) смотреть ADC_VCC и K_VCC_POWER
 #define STACK_vReadSensor     140             // Чтение датчиков
 #define STACK_vServiceHP      180             // Сервисная задача
 #define STACK_vUpdateCommand  230             // Выполнение команд управления (разбор очереди)
 #define STACK_vUpdateStepperEEV 90            // Шаговик ЭРВ
 #define STACK_vUpdateEEV      110             // Управление ЭРВ
 #define STACK_vWebX           230             // Стек задачи веб морды один поток (потоков может быть 1-4)
 #define STACK_vUpdate         230             // Стек задачи управления ТН (vUpdate)
 #define CLEAR_CHART_HP_ON                // очистка графиков при страте ТН
 #define WEB_STATUS_SHOW_VERSION	      // Показывать версию в строке статуса (запрос get_status)
 #define WEB_STATUS_SHOW_OVERHEAT    	  // Показывать перегрев в строке статуса (запрос get_status)
 #define CHART_POINT       400            // Максимальное число точек графика //360 - работает, смотрим свободную память!
 #define W5200_THREAD         4              // Число потоков для сетевого чипа w5200 допустимо 1-4 потока, на 4 скорее всего не хватить места в оперативке
 #define MQTT                                  // признак использования MQTT при неиспользовании необходимо закоментировать
 static const uint8_t defaultIP[4]      = {192, 168, 0, 177};
 static const uint8_t defaultSDNS[4]    = {192, 168, 0, 191};
 static const uint8_t defaultGateway[4] = {192, 168, 0, 1};
 static const uint8_t defaultSubnet[4]  = {255, 255, 255, 0};
 const boolean  defaultDHCP=false;
#define DEF_DELAY_ON_PUMP           60       // Задержка включения компрессора после включения насосов (сек).
#define DEF_DELAY_OFF_PUMP          60       // Задержка выключения насосов после выключения компрессора (сек).
#define DEF_DELAY_START_RES        (5*60)    // Задержка включения ТН после внезапного сброса контроллера (сек.)
#define DEF_DELAY_REPEAD_START     (10*60)   // Задержка перед повторным включениме ТН при ошибке (попытки пуска) секунды
#define DEF_DELAY_DEFROST_ON        120      // ДЛЯ ВОЗДУШНОГО ТН Задержка после срабатывания датчика перед включением разморозки (секунды)
#define DEF_DELAY_DEFROST_OFF       120      // ДЛЯ ВОЗДУШНОГО ТН Задержка перед выключением разморозки (секунды)
#define DEF_DELAY_R4WAY             120      // Задержка между переключением 4-х ходового клапана и включением компрессора, для выравнивания давлений (сек). Если включены эти опции (переключение тепло-холод)
#define DEF_DELAY_BOILER_SW         60       // Пауза (сек) после переключение ГВС - выравниваем температуру в контуре отопления/ГВС что бы сразу защиты не сработали
#define DEF_DELAY_BOILER_OFF        120      // Время (сек) на сколько блокируются защиты при переходе с ГВС на отопление и охлаждение слишком горяче после ГВС
#define DELAY_AFTER_SWITCH_RELAY	500	     // Задержка после переключения реле, для сглаживания потребления и уменьшения помех(мс)
#define DELAY_BEFORE_STOP_IN_PUMP	10		 // Задержка перед выключением насоса геоконтура, насос отопления отключается позже (сек)
#define PIN_SPI_CS_W5XXX   10       // ++ ETH-CS   сигнал CS управление сетевым чипом w5500
#define PIN_SPI_CS_SD      4        // ++ SD-CS    сигнал CS управление SD картой
#define PIN_SPI_CS_FLASH   52       // ++ FLASH-CS сигнал CS управление чипом флеш памяти (32 мБит)
#define PIN_ETH_RES         8       // ++ ETH-RES Сброс сетевого чипа w5500 активный low нормально high
#define PIN_ETH_INT         9       // ++ ETH-INT Прерывание с w5500 пока не используется надо программировать на вход
#define PIN_ETH_CS         10       // ++ ETH-CS Чип селект SPI w5500
#define PIN_LED1           38       // ++ LED1 Красный: ровно горит в обычной работе, мигает в специальном режиме
#define PIN_LED_OK         39       // ++ LED2 Зелёный, инверсный (LOW = горит). Период 3 с - норма, 0.4 с - ошибка,
#define PIN_KEY1           40       // ++ KEY1 Первая кнопка (ТН вкл/выкл). Удержание при включении выбирает режим загрузки:
#define PIN_KEY2           41       // +  KEY2 Вторая кнопка
#define PIN_KEY3           42       // +  KEY3 Третья кнопка
#define PIN_BEEP           43       // ++ SOUND Выход на пищалку. В режиме DEMO тоже 43:
#define PIN_STEP_DIAG      44       // ++ STEP-DIAG Контроль драйвера шаговика
#define PIN_NO_SD_CARD     45       // ++ CD Отсутствие карты в слоте
#define PIN_POWER_ON       50       // ++ PWR-OFF Включение питания на всю плату (включение LOW)
#define PIN_ADC_VCC        3        // ++ Нога АЦП куда заводится через делитель напряжение питания (в нумерации sam3x!) в ардуино это А4, коэффициент пересчета K_VCC_POWER
#define PIN_EEV1_D24       24       // ++ первая нога ЭРВ D24  ОРАНЖЕВЫЙ  +А
#define PIN_EEV2_D25       25       // ++ вторая нога ЭРВ D25  КРАСНЫЙ    +B
#define PIN_EEV3_D26       26       // ++ третья нога ЭРВ D26  ЖЕЛТЫЙ     -A
#define PIN_EEV4_D27       27       // ++ четвертая нога ЭРВ D27 ЧЕРНЫЙ   -B
#define PIN_DEVICE_FC      DAC0     // ++ DAC Аналоговое управление инвертором
#define PIN_MODBUS_RSE     22       // +  RS485DE  Управление направлением передачи 485 для связи с инвертором по Modbus (1-передача 0-прием)
#define ADC_SENSOR_PEVA    11       // + НОМЕР КАНАЛА ацп (внимание - в нумерации sam3x!) нога куда прицеплен датчик давления PEVA
#define ADC_SENSOR_PCON    10       // - НОМЕР канала ацп (в нумерации sam3x!) нога куда прицеплен датчик давления PCON
#define INUMBER            3       // Максимальное число контактных датчиков цифровые входы (то что поддерживается)
#define PIN_SENSOR_SLOWP   32       // ++ DIN1 Датчик низкого давления
#define PIN_SENSOR_SHIGHP  33       // ++ DIN2 Датчик высокого давления
#define PIN_SENSOR_SERRFC 34       // ++ DIN3 Сигнал ошибка инвертора
 #define SLOWP             0        // Датчик низкого давления
 #define SHIGHP            1        // Датчик высокого давления
 #define SERRFC            2        // Сигнал ошибка инвертора
struct Input_setup {
  const char * name;       // короткое имя, видно снаружи: веб-API
  const char * note;       // описание для человека
  uint8_t      pin;        // нога контроллера
  bool         test;       // состояние в режиме TEST
  bool         alarm;      // состояние, считающееся аварией (только для pALARM)
  TYPE_SENSOR  type;       // pALARM, pSENSOR или pPULSE
};
extern const Input_setup InputSetup[INUMBER];
#ifdef CONFIG_DEFINE_OBJECTS
const Input_setup InputSetup[INUMBER] = {
  { "SLOWP" , "Датчик низкого давления" , PIN_SENSOR_SLOWP , true, false, pALARM },
  { "SHIGHP", "Датчик высокого давления", PIN_SENSOR_SHIGHP, true, false, pALARM },
  { "SERRFC", "Сигнал ошибки Omron MX2" , PIN_SENSOR_SERRFC, true, false, pALARM },
};
#endif
#define FNUMBER            1       // Максимальное число частотных датчиков цифровые входы (то что поддерживается) код поддерживает ТРИ датчика максимально
#define PIN_SENSOR_FLOWCON   35     // - DIN4 Датчик потока по конденсатору
 #define FLOWCON        0        // Датчик потока по конденсатору
  #define FLOW_CONTROL							        	  // Контроль потоков через ПТО (актуален если установлены расходомеры)
struct Frequency_setup {
  const char * name;       // короткое имя, видно снаружи: веб-API
  const char * note;       // описание для человека
  uint8_t      pin;        // нога контроллера, вход прерывания
  uint16_t     kf;         // частота -> поток, сотые
  uint16_t     test;       // значение в режиме TEST, тысячные куба
  uint16_t     min;        // минимальное значение, десятые куба
};
extern const Frequency_setup FrequencySetup[FNUMBER];
#ifdef CONFIG_DEFINE_OBJECTS
const Frequency_setup FrequencySetup[FNUMBER] = {
  { "FLOWCON", "Поток через кондесатор (куб/ч)", PIN_SENSOR_FLOWCON, 3675, 700, 2 },
};
#endif
#define RNUMBER            9           // Число исполнительных устройств (всех) 7 силовых 2 - сухих контакта
#define PIN_DEVICE_RCOMP     2        // ++ PWR_ON1 Реле включения компрессора (через инвертор)
#define PIN_DEVICE_RPUMPI    12       // ++ PWR_ON2 Реле включения насоса входного контура  (геоконтур)
#define PIN_DEVICE_RPUMPO    13       // ++ PWR_ON3 Реле включения насоса выходного контура  (отопление и ГВС)
#define PIN_DEVICE_RBOILER   28       // ++ PWR_ON4 Включение ТЭНа бойлера
#define PIN_DEVICE_R4WAY      11       // ++ PWR_ON5 4-ходовой клапан
#define PIN_DEVICE_R3WAY     7        // ++ PWR_ON6 Трех ходовой кран. Переключение системы СО — ГВС (что сейчас греть)
#define PIN_DEVICE_RHEAT     30       // ++ PWR_ON7 Включение ТЭНа СО (электрокотел), может использоваться как догрев, резерв и т.д.
#define PIN_DEVICE_RPUMPB    29       // ++ PWR_ON8 Реле насоса циркуляции бойлера (ГВС)
#define PIN_OMRON_RESET      3        // ++ DOUT2 Выход для сброса инвертора
#define RCOMP              0          // Реле включения компрессора (через пускатель)
#define RPUMPI             1          // Реле включения насоса входного контура  (геоконтур)
#define RPUMPO             2          // Реле включения насоса выходного контура  (отопление и ГВС)
#define RBOILER            3          // Включение ТЭНа бойлера
#define R4WAY               4          // 4-ходовой клапан (охлаждение)
#define R3WAY              5          // Трех ходовой кран. Переключение системы СО — ГВС (что сейчас греть)
#define RHEAT              6          // Включение ТЭНа СО (электрокотел), может использоваться как догрев, резерв и т.д.
#define RPUMPB             7          // Реле насоса циркуляции бойлера (ГВС)
#define RRESET             8          // Выход для сброса инвертора
struct Relay_setup {
  const char * name;       // короткое имя, видно снаружи: веб-API
  const char * note;       // описание для человека
  uint8_t      pin;        // нога контроллера
};
extern const Relay_setup RelaySetup[RNUMBER];
#ifdef CONFIG_DEFINE_OBJECTS
const Relay_setup RelaySetup[RNUMBER] = {
  { "RCOMP"  , "Реле включения компрессора (через инвертор)"               , PIN_DEVICE_RCOMP   },
  { "RPUMPI" , "Реле включения насоса входного контура  (геоконтур)"       , PIN_DEVICE_RPUMPI  },
  { "RPUMPO" , "Реле включения насоса выходного контура (отопление и ГВС)" , PIN_DEVICE_RPUMPO  },
  { "RBOILER", "Реле включение ТЭНа бойлера (ГВС)"                         , PIN_DEVICE_RBOILER },
  { "R4WAY"  , "4-ходовой клапан (для режима охлаждения надо включить)"    , PIN_DEVICE_R4WAY   },
  { "R3WAY"  , "Трех ходовой кран, переключение ТН между отоплением и ГВС ", PIN_DEVICE_R3WAY   },
  { "RHEAT"  , "Реле включение ТЭНа системы отопления (электрокотел)"      , PIN_DEVICE_RHEAT   },
  { "RPUMPB" , "Реле насоса циркуляции бойлера (ГВС)"                      , PIN_DEVICE_RPUMPB  },
  { "RRESET" , "Выход для сброса инвертора"                                , PIN_OMRON_RESET    },
};
#endif
 #define FEED      sTemp[TCONOUTG].get_Temp()               // Подача системы СО- выход по гликолю конденсатора
 #define RET       sTemp[TCONING].get_Temp()                // Обратка системы СО- вход по гликолю конденсатора
 #define PUMP_OUT      RPUMPO                               // Насос выходного контура (отопление)
 #define PUMP_IN       RPUMPI                               // Насос входного  контура (гео или воздушник)
#define TNUMBER     14      // Максимальное число температурных датчиков (то что поддерживается)
#define SENSOR_IP           // Использование удаленных устройств( датчиков температуры смотрим IPNUMBER )
#define IPNUMBER    1       // Максимальное число удаленных датчиков, запрет использования  SENSOR_IP
#define ANUMBER     2       // Максимальное число аналоговых датчиков (то что поддерживается)
  #define TOUT        0  // 28FFBD5800160137 9 Температура улицы
  #define TIN         1  // 28FFBA5301150433 4 Температура в доме
  #define TEVAIN      2  // 28FFD35088160363 11 Температура на входе испарителя (по фреону)
  #define TEVAOUT     3  // 28FFEA4CB516052D 3 Температура на выходе испарителя (по фреону)
  #define TCONIN      4  // 28FFCF4488160308 14 Температура на входе конденсатора (по фреону)установлен 02.06.19
  #define TCONOUT     5  // 28FF2746881603EB 12 Температура на выходе конденсатора (по фреону) установлен 02.06.19
  #define TBOILER     6  // 289385A504000059 1 Температура в бойлере ГВС
  #define TACCUM      7  // 28FF4DE29216051D 7 Температура на выходе теплоаккумулятора
  #define TCOMPIN     8  // 28FF06058B160352 5 Температура на входе компрессора
  #define TCOMP       9  // 28FF2D4D881603C2 8 Температура нагнетания компрессора
  #define TEVAING     10 // 28FFB7419116049D 13 Температура на входе испарителя (по гликолю)
  #define TEVAOUTG    11 // 28FFDED0B5160398 6 Температура на выходе испарителя (по гликолю)
  #define TCONING     12 // 28FF53EBB31603B2 10 Температура на входе конденсатора (по гликолю)
  #define TCONOUTG    13 // 28FF7221911604FD 2 Температура на выходе конденсатора (по гликолю)
struct Temp_setup {
  const char *name;       // короткое имя, видно снаружи: веб-API, топики MQTT
  const char *note;       // описание для человека
  uint8_t     cfg_flags;  // бит 0 - наличие, старшие - отображение
  int16_t     min;        // минимальная допустимая температура, сотые градуса
  int16_t     max;        // максимальная допустимая
  int16_t     test;       // значение в режиме TEST
  int16_t     err;        // систематическая поправка, ДОБАВЛЯЕТСЯ к измеренной
};
extern const Temp_setup TempSetup[TNUMBER];
#ifdef CONFIG_DEFINE_OBJECTS
const Temp_setup TempSetup[TNUMBER] = {
  { "TOUT",     "Т° улицы",                             1, -3500, 4000, 1000, 0 },
  { "TIN",      "Т° в доме",                            1, -3000, 3500, 2000, 0 },
  { "TEVAIN",   "Т° на входе испарителя по фреону",     1, -1500, 2520,  300, 0 },
  { "TEVAOUT",  "Т° на выходе испарителя по фреону",    1, -1000, 4000,  400, 0 },
  { "TCONIN",   "Т° на входе конденсатора по фреону",   1, -2000, 8500, 1000, 0 },
  { "TCONOUT",  "Т° на выходе конденсатора по фреону",  1, -2000, 6520, 3000, 0 },
  { "TBOILER",  "Т° в бойлере ГВС",                     1,     0, 5510,  765, 0 },
  { "TACCUM",   "Т° на выходе теплоаккумулятора",       1,  -500, 4200,  123, 0 },
  { "TCOMPIN",  "Т° на входе компрессора (всас)",       1, -1510, 4010, -500, 0 },
  { "TCOMP",    "Т° нагнетания",                        1,   100, 8700,  500, 0 },
  { "TEVAING",  "Т° на входе испарителя по гликолю",    1, -1000, 2500,    0, 0 },
  { "TEVAOUTG", "Т° на выходе испарителя по гликолю",   1, -1000, 2500,    0, 0 },
  { "TCONING",  "Т° на входе конденсатора по гликолю",  1, -1000, 5000, 2000, 0 },
  { "TCONOUTG", "Т° на выходе конденсатора по гликолю", 1, -1000, 5500, 2000, 0 },
};
#endif
  	#define PEVA			0                // Датчик давления испарителя.
  	#define PCON			1                // Датчик давления конденсатора.
struct Analog_setup {
  const char * name;       // короткое имя, видно снаружи: веб-API
  const char * note;       // описание для человека
  uint16_t     transADC;   // отсчёты АЦП -> давление
  uint16_t     zero;       // отсчёты АЦП при нуле датчика
  int16_t      min;        // минимальное давление, сотые бара
  uint16_t     max;        // максимальное давление
  uint16_t     test;       // значение в режиме TEST
  bool         present;    // датчик есть в конфигурации
};
extern const Analog_setup AnalogSetup[ANUMBER];
#ifdef CONFIG_DEFINE_OBJECTS
const Analog_setup AnalogSetup[ANUMBER] = {
  { "PEVA", "Давление испарителя (bar)"  , 482, 285, 350, 1500, 600 , true  },
  { "PCON", "Давление конденсатора (bar)", 300, 150, 100, 3000, 1200, false },
};
#endif
  #define ADC_PRESCAL		10             // [20]  = (42 / ADCClockMhz - 1)
  #define ADC_SKIP_EXTREMUM 400            // [400] Отбрасывать максимумы/минимумы больше заданной дельты
  #define P_NUMSAMLES       1              // [1]   Число значений для усреднения показаний давления
  #define ADC_FREQ        100            // [20]  Частота опроса аналоговых датчиков
  #define FILTER_SIZE       128            // [40]  Длина фильтра для датчика давления
  #define FILTER_SIZE_OTHER 8              // [8]   Длина фильтра для остальных датчиков
	#define CHARTS_MOD_COUNT 14
	extern Charts_Mod_setup ChartsModSetup[CHARTS_MOD_COUNT];
#ifdef CONFIG_DEFINE_OBJECTS
	Charts_Mod_setup ChartsModSetup[CHARTS_MOD_COUNT] = {
		{ STATS_OBJ_Temp, TOUT },
		{ STATS_OBJ_Temp, TIN },
		{ STATS_OBJ_Temp, TBOILER },
		{ STATS_OBJ_Temp, TCOMP },
		{ STATS_OBJ_Temp, TCOMPIN },  // вход компрессора
		{ STATS_OBJ_Temp, TACCUM },   // аккумулятор
		{ STATS_OBJ_Temp, TEVAING },
		{ STATS_OBJ_Temp, TEVAOUTG },
		{ STATS_OBJ_Temp, TCONING },
		{ STATS_OBJ_Temp, TCONOUTG },
		{ STATS_OBJ_Temp, TEVAOUT },
		{ STATS_OBJ_Temp, TCONOUT },
		{ STATS_OBJ_Flow, FLOWCON },
 	   		{ STATS_OBJ_Press, PEVA }	// Давление
	};
#endif
	#define CHARTS_CONST_COUNT 8
	#define CHARTS_ONFLY_COUNT 5
	extern const Charts_Const_setup ChartsConstSetup[CHARTS_CONST_COUNT];
	extern const Charts_Const_setup ChartsOnFlySetup[CHARTS_ONFLY_COUNT];
#ifdef CONFIG_DEFINE_OBJECTS
	const Charts_Const_setup ChartsConstSetup[CHARTS_CONST_COUNT] = {
		{ STATS_OBJ_EEV, "ЭРВ" },                  // Отключать нельзя используется на странице ЭРВ
		{ STATS_OBJ_Overheat, "Перегрев" },        // Отключать нельзя используется на странице ЭРВ
		{ STATS_OBJ_Overheat2, "Цель перегрева" }, // Отключать нельзя используется на странице ЭРВ это цель перегрева
		{ STATS_OBJ_Compressor, "Частота, Гц" },
		{ STATS_OBJ_Power_FC, "Мощность компрессора" },
		{ STATS_OBJ_Power, "Потребляемая мощность" },
		{ STATS_OBJ_Voltage, "Напряжение сети" },
 		{ STATS_OBJ_COP_Full, "Full COP" }
	};
	const Charts_Const_setup ChartsOnFlySetup[CHARTS_ONFLY_COUNT] = {
		{ STATS_OBJ_Overcool, "Переохлаждение" }, // T[PCON] - TCONOUT
		{ STATS_OBJ_TCOMP_TCON, "Нагнетание - Конденсация" }, // TCOMP - TCON Отключать нельзя используется на странице ЭРВ
		{ STATS_OBJ_Delta_GEO, "Δ t° геоконтура" }, // TEVAING - TEVAOUTG
		{ STATS_OBJ_Delta_OUT, "Δ t° выхода" }, // TCONOUTG - TCONING
		{ STATS_OBJ_Power_OUT, "Выходная мощность" } // (TCONOUTG - TCONING) * FLOWCON / kfCapacity
	};
#endif
  #define HISTORY_SETUP_BASE 19
    #define HISTORY_N_TCOMPIN 2                  // TCOMPIN и перегрев на входе компрессора
    #define HISTORY_N_TCONOUT 1
  #define HISTORY_SETUP_COUNT (HISTORY_SETUP_BASE + HISTORY_N_TCOMPIN + HISTORY_N_TCONOUT)
  extern const History_setup HistorySetup[HISTORY_SETUP_COUNT];
#ifdef CONFIG_DEFINE_OBJECTS
  extern const History_setup HistorySetup[HISTORY_SETUP_COUNT];
  const History_setup HistorySetup[HISTORY_SETUP_COUNT] = {
  	{ STATS_OBJ_Temp, TOUT, NULL },
  	{ STATS_OBJ_Temp, TIN, NULL },
  	{ STATS_OBJ_Temp, TBOILER, NULL },
  	{ STATS_OBJ_Temp, TCOMP, NULL },
  	{ STATS_OBJ_Temp, TEVAING, NULL },
  	{ STATS_OBJ_Temp, TEVAOUTG, NULL },
  	{ STATS_OBJ_Temp, TCONING, NULL },
  	{ STATS_OBJ_Temp, TCONOUTG, NULL },
  	{ STATS_OBJ_Temp, TEVAOUT, NULL, 2 },
  	{ STATS_OBJ_Temp, TCOMPIN, NULL, 2 },
  	{ STATS_OBJ_Temp, TCONOUT, NULL },
	{ STATS_OBJ_PressTemp, PEVA, "TsatEVA", 2 },
	{ STATS_OBJ_Flow, FLOWCON, NULL },
	{ STATS_OBJ_EEV, STATS_EEV_Steps, "EEV" },
	{ STATS_OBJ_EEV, STATS_EEV_OverHeat, "OverHeat", 2 },
	{ STATS_OBJ_EEV, STATS_EEV_OHTarget, "OHtarget", 2 },
	{ STATS_OBJ_EEV, STATS_EEV_OverHeat2, "OverHeat2", 2 },
	{ STATS_OBJ_Compressor, 0, "Freq" },
	{ STATS_OBJ_Power, 0, "power220" },
	{ STATS_OBJ_Power_OUT, 0, "powerCO" },
	{ STATS_OBJ_COP_Full, 0, "fullCOP" },
	{ STATS_OBJ_HPState, 0, "HPState" }
  };
#endif
   #define EEV_DEF                                // Наличие ЭРВ в конфигурации
	#define EEV_STEPS              490            // Число шагов ЭРВ 480
	#define EEV_QUEUE              0              // Устаревший параметр диагностики API: очередь позиций заменена одной целью
    #define EEV_CLOSE_STEP         2              // Позиция ЭРВ - Закрыто
	#define EEV_PHASE              PHASE_8s       // ЗАДАННАЯ (можно менять) последовательность (шагов) при движении ЭРВ
  	    #define EEV_MIN_CONTROL                       // Контроль нижней границы ЭРВ - останов по ошибке.
    #define EEV_MAX_CONTROL                       // Контроль верхней границы ЭРВ, включать только если ЭРВ правильно подобран (верхняя граница не достижима в процессе работы)
	#define DEFAULT_RULE_EEV       TEVAOUT_PEVA   // Формула по умолчанию - TEVAOUT_PEVA
	#define DEFAULT_EEV_TIME	   30			  // Постоянная интегрирования времени в секундах ЭРВ СЕКУНДЫ
	#define DEFAULT_OVERHEAT       310			  // Перегрев по умолчанию (сотые градуса)
	#define DEFAULT_EEV_Kp	       100			  // ПИД Коэф пропорц.  в сотых долях (100 = 1,0); initEEV переводит в тысячные
	#define DEFAULT_EEV_Ki	       40			  // ПИД Коэф интегр.   в сотых долях (40 = 0,4)
	#define DEFAULT_EEV_Kd	       0			  // ПИД Коэф дифф.     в сотых долях (0 - выключена, на ЭРВ не влияет)
    #define DEFAULT_ERR_KP         0              // Ошибка (в сотых градуса) при которой происходит уменьшение пропорциональной составляющей ПИД ЭРВ
    #define DEFAULT_SPEED_EEV      80             // Скорость шагового двигателя ЭРВ (импульсы в сек.)
    #define DEFAULT_PRE_START_POS  100            // ПУСКОВАЯ позиция ЭРВ (ТО что при старте компрессора ПРИ РАСКРУТКЕ)
    #define DEFAULT_START_POS      90             // СТАРТОВАЯ позиция ЭРВ после раскрутки компрессора т.е. ПОЗИЦИЯ С КОТОРОЙ НАЧИНАЕТСЯ РАБОТА проходит DelayStartPos сек
    #define DEFAULT_HOLD_MOTOR     false          // Режим "удержания" шагового двигателя ЭРВ
  	#define DEF_OHCor_TDIS_TCON			2400		// Разница температура нагнетания - конденсации при 30С, 0 конденсации и перегреве OHCor_OverHeatStart (в сотых)
	#define DEF_OHCor_TDIS_TCON_Thr 	20		    // Порог, после превышения TDIS_TCON + TDIS_TCON_Thr начинаем менять перегрев (в десятых)
  		#define DEF_OHCor_CONDENSING_30_MUL 57			// Корректировка разницы Нагнетание-Конденсация на кажлые 10 градусов конденсации от 30 (в десятых), зависит от фреона
	#define DEF_OHCor_EVAPORATING_0_MUL 86			// Корректировка разницы Нагнетание-Конденсация на кажлые -10 градусов кипения от 0 (в десятых), зависит от фреона
	#define DEF_OHCor_Delay 			300         // Задержка после старта компрессора, сек
  		#define DEF_OHCor_Period 			10		    // Период в циклах ЭРВ, сколько пропустить
	#define DEF_OHCor_K 				100      	// Коэффициент (/0.001): перегрев += дельта * K
	#define DEF_OHCor_OverHeatMin 		150    		// Минимальный перегрев (сотые градуса)
	#define DEF_OHCor_OverHeatMax 		400    		// Максимальный перегрев (сотые градуса)
	#define DEF_OHCor_OverHeatStart 	300		  	// Начальный перегрев (сотые градуса)
    #define DEFAULT_DELAY_ON_PID    120            // Задержка включения EEV после включения компрессора (сек).  Точнее после выхода на рабочую позицию Общее время =delayOnPid+DelayStartPos
    #define DEFAULT_DELAY_ON        5             // Задержка между открытием (для старта) ЭРВ и включением компрессора, для выравнивания давлений (сек). Если ЭРВ закрывлось при остановке
    #define DEFAULT_DELAY_START_POS 30            // Время после старта компрессора когда EEV выходит на стартовую позицию - облегчение пуска вначале ЭРВ
    #define DEFAULT_DELAY_OFF       10            // Задержка закрытия EEV после выключения насосов (сек). Время от команды стоп компрессора до закрытия ЭРВ = delayOffPump+delayOff
  const boolean DEVICEFC=true;                // Наличие Частотного преобразователя в конфигурации
  #define FC_USE_RCOMP                        // Использовать для пуска/остановки инвертора отдельный выход RCOMP (команда по Modbus не посылается)
  #define FC_DT_CON_PRESS     50               // Защита по давлению компрессора - сколько сотых бара не доходит до максимальной (PCON) и при этом происходит уменьшение частоты
  #define FC_MAX_POWER        (1.8*1000)       // Максимальная мощность инвертора (см компрессор) в ВАТТАХ (get_power() отдаёт Вт)
  #define FC_MAX_POWER_BOILER (1.3*1000)       // Максимальная мощность инвертора в режиме ГВС (см компрессор) в ВАТТАХ
  #define FC_MAX_CURRENT      (10.0*100)       // Максимальный ток инвертора (см компрессор) в 0.01 А
  #define FC_MAX_CURRENT_BOILER (11.0*100)     // Максимальный ток инвертора для ГВС в 0.01 А
  #define FC_BASE_FREQ        (120*100)        // Основная частота инвертора (см компрессор) в 0.01 Гц
  #define FC_ACCEL_TIME       (60*100)         // Время разгона (см компрессор) в 0.01 сек
  #define FC_DEACCEL_TIME     (10*100)         // Время торможения (см компрессор) в 0.01 сек; 10 с - значение инвертора по умолчанию (F003)
  #define FC_STOP_WAIT_S      (FC_DEACCEL_TIME/100 + 30)   // с ожидания остановки после снятия RCOMP
  #define FC_STOP_FALLBACK_S  15                           // с после команды частоты 0
  #define FC_INIT_STOP_WAIT_S (FC_STOP_WAIT_S + FC_STOP_FALLBACK_S + 15)
  #define FC_START_PID_DELAY  (30*100)         // Задержка ПИД после старта компрессора
  #define DEF_FC_DT_COMP_TEMP     (5*100)        // Защита по температуре компрессора - сколько градусов не доходит до максимальной (TCOMP) и при этом происходит уменьшение частоты
  #define DEF_FC_UPTIME           (10)         // Время обновления алгоритма пид регулятора (СЕКУНДЫ, 3...599) Основной цикл управления
  #define DEF_FC_PID_FREQ_STEP    (2*100)        // Максимальный шаг (на увеличение) изменения частоты при ПИД регулировании в 0.01 Гц Необходимо что бы ЭРВ успевал
  #define DEF_FC_PID_STOP            90          // Проценты от уровня защит (мощность, ток, давление, темпеартура) при которой происходит блокировка роста частоты пидом (плавный подход к границе)
  #define DEF_FC_START_FREQ        (55*100)       // Стартовая частота частота инвертора отопление/охлаждение (см компрессор) в 0.01 Гц
  #define DEF_FC_START_FREQ_BOILER (45*100)      // Стартовая частота частота инвертора ГВС (см компрессор) в 0.01 Гц ГВС
  #define DEF_FC_MIN_FREQ         (40*100)       // Минимальная  частота инвертора при нагреве (см компрессор) в 0.01 Гц
  #define DEF_FC_MIN_FREQ_COOL    (60*100)       // Минимальная  частота инвертора при охлаждении в 0.01 Гц
  #define DEF_FC_MIN_FREQ_BOILER  (40*100)       // Минимальная  частота инвертора при нагреве ГВС в 0.01 Гц
  #define DEF_FC_MIN_FREQ_USER    (35*100)       // Минимальная  частота инвертора РУЧНОЙ РЕЖИМ (см компрессор) в 0.01 Гц
  #define DEF_FC_MAX_FREQ         (130*100)      // Максимальная частота инвертора при нагреве (см компрессор) в 0.01 Гц
  #define DEF_FC_MAX_FREQ_COOL    (100*100)      // Максимальная частота инвертора в режиме охлаждения  в 0.01 Гц
  #define DEF_FC_MAX_FREQ_BOILER  (50*100)       // Максимальная частота инвертора в режиме ГВС в 0.01 Гц поглощение бойлера обычно меньше чем СО
  #define DEF_FC_MAX_FREQ_USER    (120*100)      // Максимальная частота инвертора РУЧНОЙ РЕЖИМ (см компрессор) в 0.01 Гц
  #define DEF_FC_MAX_FREQ_GEN     (50*100)       // Максимальная частота инвертора при работе от генератора (резервное питание) в 0.01 Гц; 0 срезает любое задание частоты до нуля
  #define DEF_FC_STEP_FREQ        (2*100)        // Шаг уменьшения частоты инвертора при достижении максимальной температуры, мощности и тока (см компрессор) в 0.01 Гц
  #define DEF_FC_STEP_FREQ_BOILER (5*100)        // Шаг уменьшения частоты инвертора при достижении максимальной температуры, мощности и тока ГВС в 0.01 Гц
  #define DEF_FC_DT_TEMP          (1*100)        // Привышение температуры от уставок (подача) при которой срабатыват защита (уменьшается частота) в сотых градуса
  #define DEF_FC_DT_TEMP_BOILER   (2*100)        // Привышение температуры от уставок (подача) при которой срабатыват защита ГВС в сотых градуса
