pav2000/ControlHeatPump2.0/Control/src/hw/StepMotor.cpp

/*
 * Copyright (c) 2016-2026 by Pavel Panfilov <firstlast2007@gmail.com>  telegram @pav20000
 * &                       by Vadim Kulakov vad7@yahoo.com, vad711
 * "Народный контроллер 2.0" для тепловых насосов.
 * Данное программное обеспечение предназначено для управления
 * различными типами тепловых насосов для отопления и ГВС.
 *
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
 * This file is distributed in the hope that it will be useful,
 * but WITHOUT ANY WARRANTY; without even the implied warranty of
 * MERCHANTABILITY or FITNESS FOR A PARTICULAR PURPOSE.See the
 * GNU General Public License for more details.
 */
#include "StepMotor.h"

void StepMotor::initStepMotor(int number_of_steps, int motor_pin_1, int motor_pin_2, int motor_pin_3, int motor_pin_4,
                              uint8_t phase_variant, bool invert)
{
	this->number_of_steps = number_of_steps; // total number of steps for this motor
	this->pin_count = 4;
	this->phase_variant = phase_variant;       // из Config.h через вызывающего
	this->invert = invert;                     // инверсия выходов драйвера L9333

	// Arduino pins for the motor control connection:
	this->motor_pin_1 = motor_pin_1;
	this->motor_pin_2 = motor_pin_2;
	this->motor_pin_3 = motor_pin_3;
	this->motor_pin_4 = motor_pin_4;
	// setup the pins on the microcontroller:
	pinMode(this->motor_pin_1, OUTPUT);
	pinMode(this->motor_pin_2, OUTPUT);
	pinMode(this->motor_pin_3, OUTPUT);
	pinMode(this->motor_pin_4, OUTPUT);
	off();                     // Снять напряжение
}


// Установить скорость поступления шагов
void StepMotor::setSpeed(long whatSpeed)
{
	step_delay = 1000 / whatSpeed; // пересчет на время одного шага в мсек
}


// Новая цель заменяет предыдущую. Короткая секция согласует запрос со шагом.
bool StepMotor::step(int steps_to_move)
{
	taskENTER_CRITICAL();
	if(motion.snapshot().position < 0) motion.reset(0);
	bool ok = motion.moveTo(steps_to_move, 0, number_of_steps) == EevMotion::ACCEPTED;
	taskEXIT_CRITICAL();
	if(ok && xHandleStepperEEV != NULL) xTaskNotifyGive(xHandleStepperEEV);
	return ok;
}

bool StepMotor::home(int overrun)
{
	taskENTER_CRITICAL();
	bool ok = motion.home(number_of_steps, overrun) == EevMotion::ACCEPTED;
	taskEXIT_CRITICAL();
	if(ok && xHandleStepperEEV != NULL) xTaskNotifyGive(xHandleStepperEEV);
	return ok;
}

bool StepMotor::isBusy()
{
	taskENTER_CRITICAL();
	bool active = motion.snapshot().mode != EevMotion::IDLE;
	taskEXIT_CRITICAL();
	return active;
}

bool StepMotor::canRetarget()
{
	taskENTER_CRITICAL();
	EevMotion::Mode mode = motion.snapshot().mode;
	taskEXIT_CRITICAL();
	return mode == EevMotion::IDLE || mode == EevMotion::MOVING;
}

int16_t StepMotor::currentPosition()
{
	taskENTER_CRITICAL();
	int16_t position = motion.snapshot().position;
	taskEXIT_CRITICAL();
	return position;
}

bool StepMotor::driveOne(int16_t &position)
{
	taskENTER_CRITICAL();
	bool move = motion.prepareStep(position);
	taskEXIT_CRITICAL();
	if(!move) return false;
	stepOne(position % StepMotor_PhaseCount(phase_variant));
	taskENTER_CRITICAL();
	motion.commitStep();
	taskEXIT_CRITICAL();
	return true;
}

// выставить один пин
// Инверсия - поле объекта, а не #ifdef: DRV_EEV_L9333 живёт в Config.h,
// которого эта единица трансляции не видит.
__attribute__((always_inline)) inline void StepMotor::setPinMotor(int pin, boolean val)
{
	digitalWriteDirect(pin, invert ? !val : val);
}

// Выставить все четыре обмотки по маске: бит 3 - обмотка 1, бит 0 - обмотка 4.
// Единственное место, где номера пинов сопоставляются битам маски, - и фаза,
// и снятие напряжения идут через него.
__attribute__((always_inline)) inline void StepMotor::applyMask(uint8_t mask)
{
	setPinMotor(motor_pin_1, mask & 0x8);
	setPinMotor(motor_pin_2, mask & 0x4);
	setPinMotor(motor_pin_3, mask & 0x2);
	setPinMotor(motor_pin_4, mask & 0x1);
}
/*
 * Движение на один шаг  в зависимости от выбранной последовательности
 */
// Выставить обмотки по номеру фазы.
// Сама последовательность живёт в модуле StepMotorPhase.cpp и проверяется
// тестами.
//
// Вариант последовательности - поле объекта: EEV_PHASE приходит из Config.h,
// которого эта единица трансляции не видит, и задаётся в initStepMotor.
void StepMotor::stepOne(int thisStep)
{
	uint8_t m = StepMotor_PhaseMask(phase_variant, (uint8_t)thisStep);
	// При номере фазы вне диапазона пины не трогаются вовсе: обесточивать обмотки
	// нельзя, потеряется удержание и положение ЭРВ.
	if(m == SM_PHASE_INVALID) return;
	applyMask(m);
}



// Снять напряжения с шаговика
// Снять напряжение со всех обмоток - это просто пустая маска.
void StepMotor::off()
{
	applyMask(0);
}
              
