pav2000/ControlHeatPump2.0/Control/src/core/HeatPump.h

/*
 * Copyright (c) 2016-2026 by Pavel Panfilov <firstlast2007@gmail.com>  telegram @pav20000
 * &                       by Vadim Kulakov vad7@yahoo.com, vad711
 * "Народный контроллер 2.0" для тепловых насосов.
 * Данное программное обеспечение предназначено для управления
 * различными типами тепловых насосов для отопления и ГВС.
 *
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
 * This file is distributed in the hope that it will be useful,
 * but WITHOUT ANY WARRANTY; without even the implied warranty of
 * MERCHANTABILITY or FITNESS FOR A PARTICULAR PURPOSE.See the
 * GNU General Public License for more details.
 */
// ---------------------------------------------------------------------------
// Описание базовых классов для работы Теплового Насоса
// ---------------------------------------------------------------------------
#ifndef HeatPump_h
#define HeatPump_h
#include "../../Constant.h"                       // Вся конфигурация и константы проекта Должен быть первым !!!!
#include <stddef.h>                         // offsetof - для проверок раскладки сохраняемых структур
#include "../hw/Hardware.h"
#include "../net/Message.h"
#include "Profile.h"
#include "Rtos.h"       // хендлы задач, семафоры, счётчики состояния контроллера
#include "CommandQueue.h" // очередь команд управления ТН
#include "ClimateControl.h" // решение об управлении, мощности и COP
#include "MotoHour.h"    // счётчики наработки: структуры записи и операции над ними
#include "SettingsLegacy.h" // чтение старых форматов сохранения, файл целиком к удалению
#include "../net/MQTT.h"
#include "../hw/OmronFC.h"
#include "../hw/VaconFC.h"
#include "Scheduler.h"
#include "WarningRecord.h"
#include "PressureProtection.h"


int32_t updatePID(int32_t errorPid, PID_STRUCT &pid, PID_WORK_STRUCT &pidw);
void UpdatePIDbyTime(uint16_t new_time, uint16_t curr_time, PID_STRUCT &pid);

/*/ Структура для хранения заголовка при сохранении настроек EEPROM
struct type_headerEEPROM    // РАЗМЕР 1+1+2+2=6 байт
{
  uint16_t ver;             // номер версии для сохранения
  uint16_t len;             // длина данных, сколько записано байт в еепром
 };
*/

// Структура описывающая текущее состояние ТН (хранится только в памяти)
struct type_status
{
   MODE_HP modWork;         // Что делает ТН если включен (7 стадий)  0 Пауза 1 Включить отопление  2 Включить охлаждение  3 Включить бойлер   4 Продолжаем греть отопление 5 Продолжаем охлаждение 6 Продолжаем греть бойлер
   TYPE_STATE_HP State;     // Состояние теплового насоса  0 ТН выключен   1 Стартует 2 Останавливается  3 Работает 4 Ожидание ТН (расписание - пустое место) 5 Ошибка ТН  6 - Эта ошибка возникать не должна!
   int8_t ret;              // Точка выхода из алгоритма регулирования
   int8_t prev;             // Предыдущая точка выхода из алгоритма регулирования
}; 
// Структура для хранения различных счетчиков (максимальный размер 128-1 байт!!!!!)
#define fMH_ON    	0       // флаг Включения ТН (пишется внутрь счетчиков flags)

// Счётчики и флаг графиков. Заголовок их ОБЪЯВЛЯЕТ, создаются они в
// HeatPump.cpp: определение объекта в заголовке запрещает включить его
// во вторую единицу трансляции, а значит и перевести в модуль кого-либо
// из тех, кто эти счётчики читает (HeatPumpSettings, Statistics).
extern int32_t  motohour_OUT_work;   // рабочий для счётчиков - энергия на выходе
extern int32_t  motohour_IN_work;    // рабочий для счётчиков - энергия на входе
extern uint16_t task_updstat_chars;
extern boolean  Charts_when_comp_on; // графики в памяти только при работе компрессора

// Рабочие флаги ТН
#define fHP_BoilerTogetherHeat	0			// Идет нагрев бойлера вместе с отоплением

//  Работа с отдельными флагами, type_optionHP.flags:
#define fAddHeat				0               // флаг Использование дополнительного тена при нагреве
#define fBeep					1               // флаг Использование звука
#define fNextion				2               // флаг Использование nextion дисплея
#define fHistory				3               // флаг записи истории на карту памяти
#define fSaveON					4               // флаг записи в EEPROM включения ТН
#define fTypeRHEAT				5               // флаг как используется дополнительный ТЭН для нагрева 0-резерв 1-бивалент
#define fReserved6				6				// РЕЗЕРВ: раньше "на шине 1 1-Wire только один датчик" (шины 2-4 нет, флаг не использовался). Не занимать без нужды
#define fReserved7				7				// РЕЗЕРВ: раньше "на шине 2 1-Wire только один датчик" (шины 2-4 нет, флаг не использовался). Не занимать без нужды
#define fReserved8				8				// РЕЗЕРВ: раньше "на шине 3 1-Wire только один датчик" (шины 2-4 нет, флаг не использовался). Не занимать без нужды
#define fReserved9				9				// РЕЗЕРВ: раньше "на шине 4 1-Wire только один датчик" (шины 2-4 нет, флаг не использовался). Не занимать без нужды
#define fSDMultiBlock			10				// флаг Многоблочное чтение SD (CMD18). Бит прежде нигде не использовался (был резерв "СК для регенерации геоконтура"), в сохранённых настройках 0
#define fNextionOnWhileWork		11				// Включать дисплей, когда компрессор работает
#define fWebStoreOnSPIFlash		12				// флаг, что веб морда лежит на SPI Flash, иначе на SD карте
#define fReserved13				13				// РЕЗЕРВ: раньше "логировать обмен беспроводных датчиков" (радио удалено)
#define fBackupPower			14				// Использование резервного питания от генератора (ограничение мощности)
#define fSDMLogErrors			15              // УСТАРЕЛО: перенесён в флаг отладки SDM (DebugFlags.h), читается только при переносе настроек
//  type_optionHP.flags2:
#define f2BackupPowerAuto		0               // Автоматически определять работу от генератора (через датчик SGENERATOR)
#define f2HistoryDetail		1               // Детализация истории ВКЛ/ВЫКЛ компрессора: запись раз в HISTORY_DETAIL_PERIOD с вокруг пуска и останова
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
