pav2000/ControlHeatPump2.0/Control/src/hw/SensorTemp.cpp

/*
 * Copyright (c) 2016-2026 by Pavel Panfilov <firstlast2007@gmail.com>  telegram @pav20000
 * &                       by Vadim Kulakov vad7@yahoo.com, vad711
 * "Народный контроллер 2.0" для тепловых насосов.
 * Данное программное обеспечение предназначено для управления
 * различными типами тепловых насосов для отопления и ГВС.
 *
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
 * This file is distributed in the hope that it will be useful,
 * but WITHOUT ANY WARRANTY; without even the implied warranty of
 * MERCHANTABILITY or FITNESS FOR A PARTICULAR PURPOSE.See the
 * GNU General Public License for more details.
 */
/*
 * Датчики температуры: отдельная единица трансляции.
 *
 * SensorTemp.h тянет Constant.h, а с ним Config.h, поэтому #ifdef SENSOR_IP,
 * #ifdef DEMO и #if T_NUMSAMLES разрешаются так же, как в главной единице
 * трансляции. Проверено сверкой размеров методов.
 */
#include "SensorTemp.h"
#include "../core/SettingsLegacy.h"   // чтение старых форматов, файл к удалению
#include "Hardware.h"      // rtcSAM3X8, addressToHex
#include "../core/HeatPump.h"      // HP, set_Error
#include "../log/Journal.h"       // journal
#include "../core/Rtos.h"          // _delay, замки шин
#include "../net/ParamRegistry.h"   // таблица параметров веб-API (внизу файла)
#include "BusOneWire.h"            // OW_scanTable
#include "SensorPick.h"            // выбор значения с удалённым датчиком
// ---------------------------------------------------------------------------
// ---- Цифровые датчики температуры ----
 // Инициализация на входе номер датчика
void sensorTemp::initTemp(int sensor)
    { 
      err=OK;                                  // ошибка датчика (работа)
      numErrorRead=0;                          // Ошибок нет
      sumErrorRead=0;                          // ошибок нет
      cfg.number = sensor;
      minTemp=TempSetup[sensor].min;                 // минимальная разрешенная температура
      maxTemp=TempSetup[sensor].max;                 // максимальная разрешенная температура
      cfg.errTemp=TempSetup[sensor].err;                 // статическая ошибка датчика
      cfg.testTemp=TempSetup[sensor].test;               // Значение при тестировании
      lastTemp=STARTTEMP;                      // последняя считанная температура с датчика по умолчанию абсолютный ноль
      Temp=0;                                  // температура датчика (обработанная)
      flags=0x00;                              // Сбросить все флаги
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
