pav2000/ControlHeatPump2.0/(commit log)

2026-10-21 Заливка первой версии
    [4.3-Bezel.STL, 4.3-Display.STL, Дно 4.3.stl]
2026-10-21 Добавлен виджет погоды на главную страницу
2026-10-22 Мелки правки веб морды (недочеты)
2026-10-22 исправления ошибок веб морды, исправление графика погоды
2026-10-22 Редактирование файлов справок
2026-10-22 Исправление ошибок авторизации (вылечено не до конца)
    [Constant.h, HeatPump.cpp, Util.cpp, Util.h, WebServer.cpp]
2026-10-22 Добавление новый файлов справок для различных страниц
2026-10-22 Оптимизация работы по modbus
2026-10-22 Обновлено описание
2026-10-22 Мелкие правки кода, исправление схемы на вебморде
    [Control.ino, Journal.cpp, Nextion.cpp, OmronFC.cpp, SensorTemp.cpp]
2026-10-23 очередь команд
2026-10-23 Отказ от __attribute__((naked)) - есть риск Поднятие версии.
2026-10-23 Версия 2.21 загрузка настроек
    Оптимизация загрузки настроек и профилей из веба (атомарность)).
2026-10-23 Версия 2.23
    Пауза насосов и циркуляция ГВС в ClimateControl, исправление неточностей работы и мелких ошибок
    [ClimateControl.cpp, ClimateControl.h, Constant.h, Control.ino, SchedulerCalc.cpp, SchedulerCalc.h]
2026-10-26 Исправление мелких ошибок веба
    [Config.h, Constant.h, EEV.cpp, HeatPumpControl.cpp, HeatPumpSettings.cpp, Message.cpp, Modbus.cpp, NoSDpage.h]
2026-10-26 Исправление ошибок веб
2026-10-26 Добавлен сброс после ошибок ядра ОС
2026-10-27 исправлена ошибка ввода значений с точностью сотые
2026-10-27 Исправление ошибок в коде + усиление контроля W5500
    Усиление контроля за сетевым чипом, изменение алгоритма контроля, увеличение диагностических сообщений.
    Исправление конфликтов по SPI шине
    Мелкие правки кода
    [ClimateControl.cpp, ClimateControl.h, Clock.cpp, Config.h, Constant.h, Control.ino, DateTime.cpp, DateTime.h]
2026-10-27 Оптимизация работы с W5500, расширение диагностики сети
2026-10-29 Оптимизация работы всех устройств на SPI шине
    Добился увеличения скорости загрузки морды до 3 раз
2026-10-29 Страница информации об SPI
    Добавлена страница информации и тестов устройств SPI
    Начало доработок для Watchdog, причины перезагрузки
2026-10-29 Единая структура состояния загрузки
2026-10-30 мелкие правки
    Аварийный останов компрессора одной функцией, границы kf и press.trans, предел частоты от генератора, мелочи
2026-10-30 Упорядочивание времени и оптимизация его работы
    Интервалы защит и задержек считаются по времени работы Uptime_s(), а не по настенным часам: пауза и минимальная работа компрессора, задержки ЭРВ и ПИД частоты, ГВС, обеззараживание, повтор почты, свежесть датчиков IP.
    Скачок часов (NTP, I2C, ручная установка) на них больше не влияет; Прежде сдвиг не доставал отметку пуска в самих драйверах O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
2026-11-02 Исправлены ошибки
    Modbus: пустой замок шины отвергается только после старта планировщика
    Аварийный останов (set_Error) и общее выключение реле при останове снимают реле всеми
    источниками
    ТЭН отопления (RHEAT) включается только при работающем насосе выходного контура и выключается при его остановке
    Ручное управление выходами через API (relay.<имя>.on, fc.on_off, eev.pos, eev.posp, действие modbus.write) только п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
    [ClimateControl.cpp, ClimateControl.h, Constant.h, EEV.cpp, Hardware.h, HeatPump.cpp, HeatPump.h, HeatPumpSettings.cpp]
2026-11-02 Мелкие исправления
    Привязка датчиков (temp.<имя>.addr, ipsens.<N>.link) меняется только при остановленном ТН: на работающем ответ busy.
    Время по HTTP (HTTP_TIME_REQUEST): ответ разбирается проверенной функцией Http_ParseTime
    Выгрузка истории читает текущий блок из ОЗУ вместе с его номером под коротким запретом прерываний
    [Clock.cpp, Constant.h, Control.ino, DateTime.cpp, DateTime.h, Device.h, HeatPump.cpp, HeatPump.h]
2026-11-02 Убраны не используемые константы
2026-11-02 Версия 2.35 ЭРВ: два алгоритма - ПИД и новый «Гибрид»
    Алгоритм Прямого управления удален.
    Формат настроек 151
    Добавлено стартовая позиция по стартовой частоте инвертора
2026-11-03 Оптимизация работы w5500 в сетях с большим пингом (VPN)
    Веб: ожидание закрытия TCP-соединения освобождает сетевой замок; заголовок статического файла отправляется с первым куском данных
    Настройка `net.sock_fast`: раскладка передачи W5500 4/2/2/2/2/2/0/2 КБ, 6 веб-сокетов, быстрый сокет 0.
    Ручной таймаут повтора `net.rtr`: 100–2000 мс, по умолчанию 400.
    Морда: действия пользователя сохраняют порядок отправки в пр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
2026-11-03 Версия 2.36. Обновление инструкции
2026-11-04 Новое лого
2026-11-04 Параметры ЭРВ (проверка на допустимость и применимость)
    Границы проверяются перед применением записей старого и нового формата; запись пределов использует тот же инвариант, процентный расчёт защищён от нулевого хода.
2026-11-04 Исправление ошибки вывода мощности инвертора Vacon
    Был ошибочный запрос на схеме. Запрос был fc.info1 а надо fc.cpower
    [WebApiGet.cpp]
2026-11-04 Добавлена поддержка инвертора VACON 20
    Выбор инвертора VACON 10 или 20 делается в файле VaconFC.h (#define VACON_MODEL)
    Для 20 надо запрограммировать регистр 852 в значение 8 (старое 0)
    В журнал при старте пишется сообщение об этом регистре
2026-11-04 VACON 20 update
    Забыл докинуть все файлы от других правок.
2026-11-05 Версия 2.37 Оптимизация работы ЭРВ + Vacon 20
    ЭРВ: очередь промежуточных позиций заменена одной изменяемой целью; новая цель действует со следующего шага. Поиск нуля выделен в отдельное состояние, пуск дожидается его завершения, а штатный STOP сохраняет асинхронное закрытие.
    Прямые команды ЭРВ согласованы с пуском и состоянием шаговика. На выключенном ТН можно изменить цель во время обы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
2026-11-05 Исправление ошибки путей в либе w5500 к NetLayout.h
2026-11-09 Исправление по vacon 20 (привод заработал)
    Заставили работать vacon 20 было много ошибок и не точностей + привод не был согласован с инвертором. Не забываем увеличивать таймаут в либе мобас.
    [VaconFC.cpp, VaconFC.h]
2026-11-09 Версия 2.38 мелки правки веб морды
    График и CSV «Нагнетание − Конденсация» используют тот же источник температуры конденсации, что и текущий расчёт.
    На странице ЭРВ показатель `eev.ctdelta` назван «Цель: Нагн. − конд.»; уточнена справка.
2026-11-09 Дополнительные проверки библиотек Modbus MQTT
    Modbus буфер ADU увеличен до размера максимального кадра, добавлены проверки количества данных и границ передающего/приёмного буфера.
    MQTT: Remaining Length ограничен четырьмя байтами, проверяются переполнение, обрыв, размер пакета, тема и идентификатор QoS1.
    Modbus: проверяются допустимые количества регистров до передачи, исправлена сборка кадров записи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
2026-11-09 Доработка либ работающих по spi
    SerialFlash и W5500 теперь передают ошибки DMA/SPI на верх
    Файл истории: последний неполный буфер теперь отправляется (раньше нет)
2026-11-09 Проверки времен ожиданий SPI
    Сетевые сеансы: после переинициализации W5500 старые операции получают новое поколение сети и прекращаются перед закрытием сокета.
    Ожидания SPI и DMA в общей шине получили конечный тайм-аут
    Ожидания команд W5500, стабильного размера буфера и завершения `busy/suspend` SerialFlash ограничены по времени
    Тайм-ауты W5500 передаются в `sendUDP`, обычная передача больше не ждёт `SEND_OK`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
2026-11-11 Версия 2.39. Рефакторинг подсистемы ошибок ТН
    Сплошной список ошибок (убрал дырки).
    Возможность вывода собственных ошибок частотника и модбас.
    Единый формат вывода.
    Деление на ошибки и предупреждения.
    Адаптация веб морды под это.
2026-11-12 Добавление новых защит и предупреждений
    Добавлены:
    Защиты давления
    Перегрев на всасывании
    Отключение ТЭНа бойлера (доработка)
    Сервисные предупреждения (связь и железо)
